alephobjects/taz-toolhead-opah/images/color_options/IMG_3160.JPG

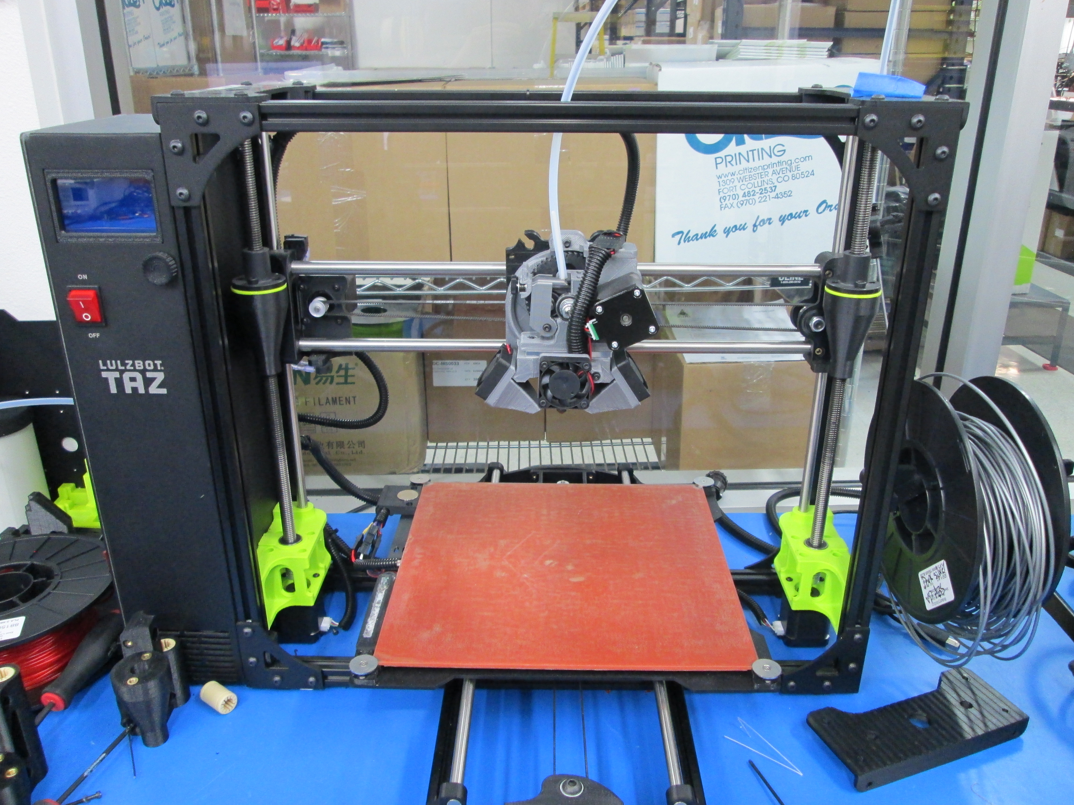
images/color_options/IMG_3160.JPG
