alephobjects/taz-toolhead-opah/images/IMG_2776.JPG

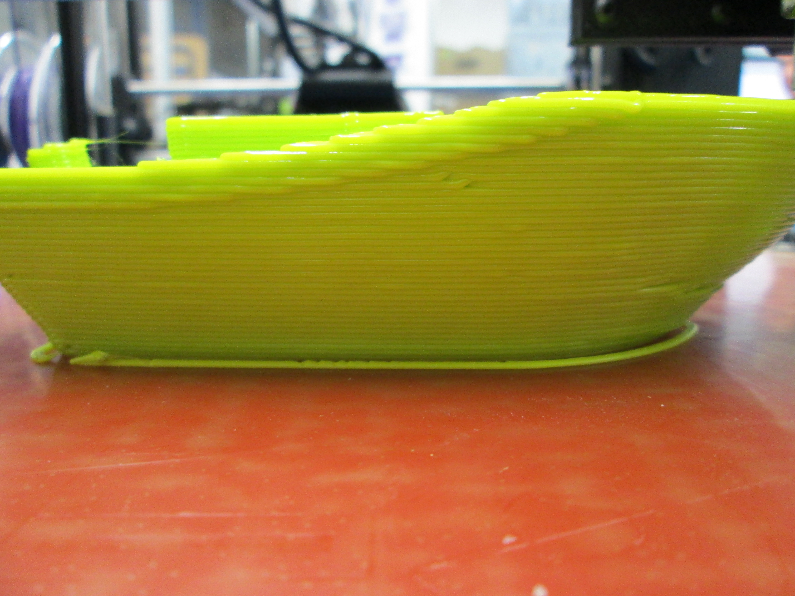
images/IMG_2776.JPG
