alephobjects/taz-toolhead-opah/production_docs/potential_retail_names.odt

Potential Opah retail names

- MOAR
- LulzBot LongBlock
- High Output Toolhead
- Hellashcnozzle
- Bignoz
- SuperSchnoz
- Cauldera
- Uberstruder
