alephobjects/taz-toolhead-opah/production_docs/notes/opah_to-do.odt

Opah todo

- Modify extruder body (rotate m4 mounting nut) (BAM)
  - print new version (Brent I)
  - validate new version (Mickey)
- Fix leaking at top of heater block (BAM)(Julie)(Mickey) Going to use resbond blue as with the standard AO-Hex
  - Resbond Blue
    - Known, but known issue (low risk)
  - Permatex Red high temp RTV
    - Unknown, but likely better (higher risk)
    - Rated to ~350C, so not future proof
- Decide on nozzle material – We're goin with Copper Alloy 328
  - Chrome Zirc 328
    - Low risk, but have over-torqued to failure
    - Similar to current nozzle with known printing and wiping abilities
  - Hardened steel
    - Higher risk, but would allow greater lifetime with abrasives
    - Wiping and printing abilities only tested for ~20 hrs, but no issues.
- Build up photo toolhead
  - Make production looking printed parts
  - Get HB laser etched
    - Decide on location for HOT logo
    - Will we also be etching writing?
  - Need picture for cura by 7/27
- Finalize printed parts
- Finalize machined parts
- Finalize vitamins
- Finalize packaging (preferred Packaging?)
  - Drop test
  - Artwork
  - Update BOM
- Finalize release print profiles
  - ABS
    - TAZ4/5 (HS, MQ, HQ)
    - TAZ6 (HS, MQ, HQ)
  - Polylite
    - TAZ4/5 (HS, MQ, HQ)
    - TAZ6 (HS, MQ, HQ)
  - nGen
    - TAZ4/5 (HS, MQ, HQ)
    - TAZ6 (HS, MQ, HQ)
  - INNOVA1800
    - TAZ4/5 (HS, MQ, HQ)
    - TAZ6 (HS, MQ, HQ)
  - T-Glase
    - TAZ4/5 (High clarity, HS, MQ, HQ)
    - TAZ6 (High clarity, HS, MQ, HQ)
  - PC-MAX
    - TAZ4/5 (HS, MQ, HQ)
    - TAZ6 (HS, MQ, HQ)
- Validate build OHAI
- Validate install OHAI
