alephobjects/taz-toolhead-opah/production_docs/notes/opah_hotend_notes.odt

Opah timeline

Beta testing begins 7/16

Bom and profile lock 8/01

Proproduction (~10 units) ??

Initial production run 9/01

Questions:

What is lead-time for 500 units?

Current action items

AO

* Need to decide on laser etching for the block and what type of nozzle identifier to use

* Mount plate was missed in initial sample run (oops)

- Getting these for preproduction run should be fine

* Heater block was redesigned to reduce cost, rounded edges are now just chamfered to match E3D block.

E3D

* Need to provide retention plate samples

* Also need to get thermistor assemblies with correct molex connector
