alephobjects/taz-toolhead-opah/images/bowling_pins_9hrs_ABS.JPG

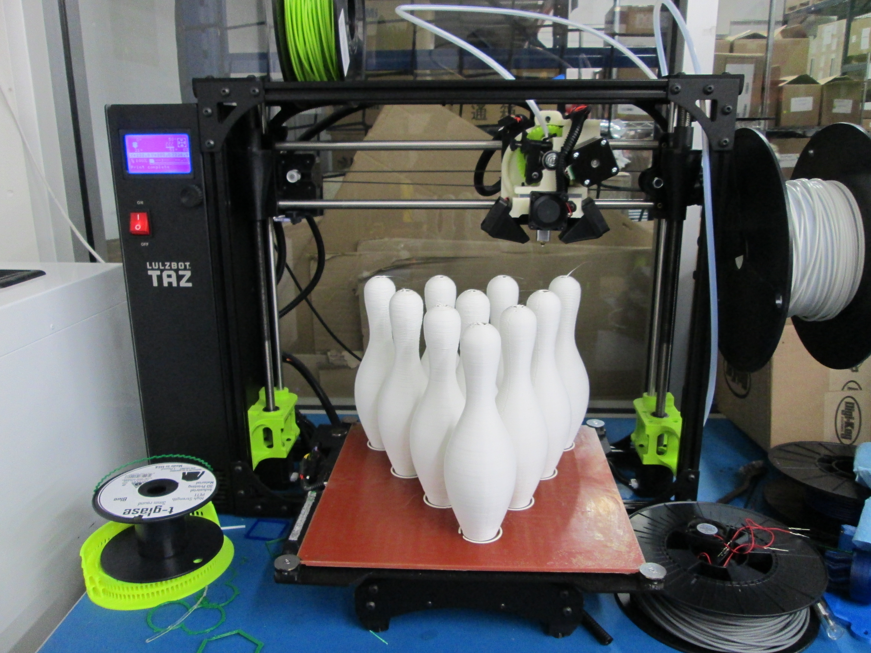
images/bowling_pins_9hrs_ABS.JPG
