alephobjects/taz-toolhead-opah/images/color_options/IMG_3157.JPG

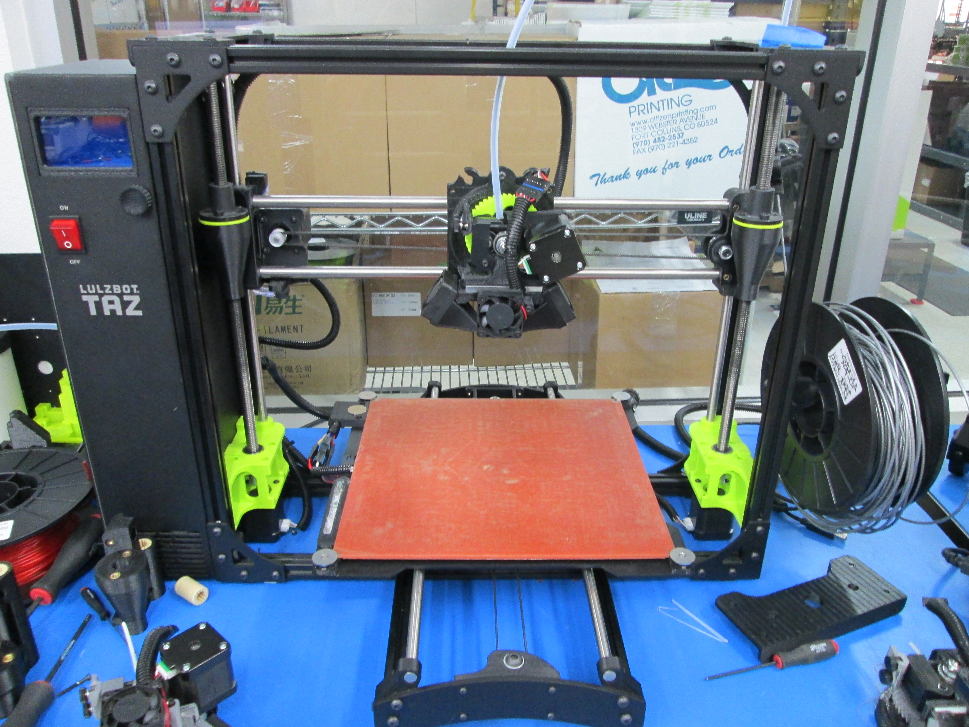
images/color_options/IMG_3157.JPG
