alephobjects/taz-toolhead-opah/images/color_options/IMG_3159.JPG

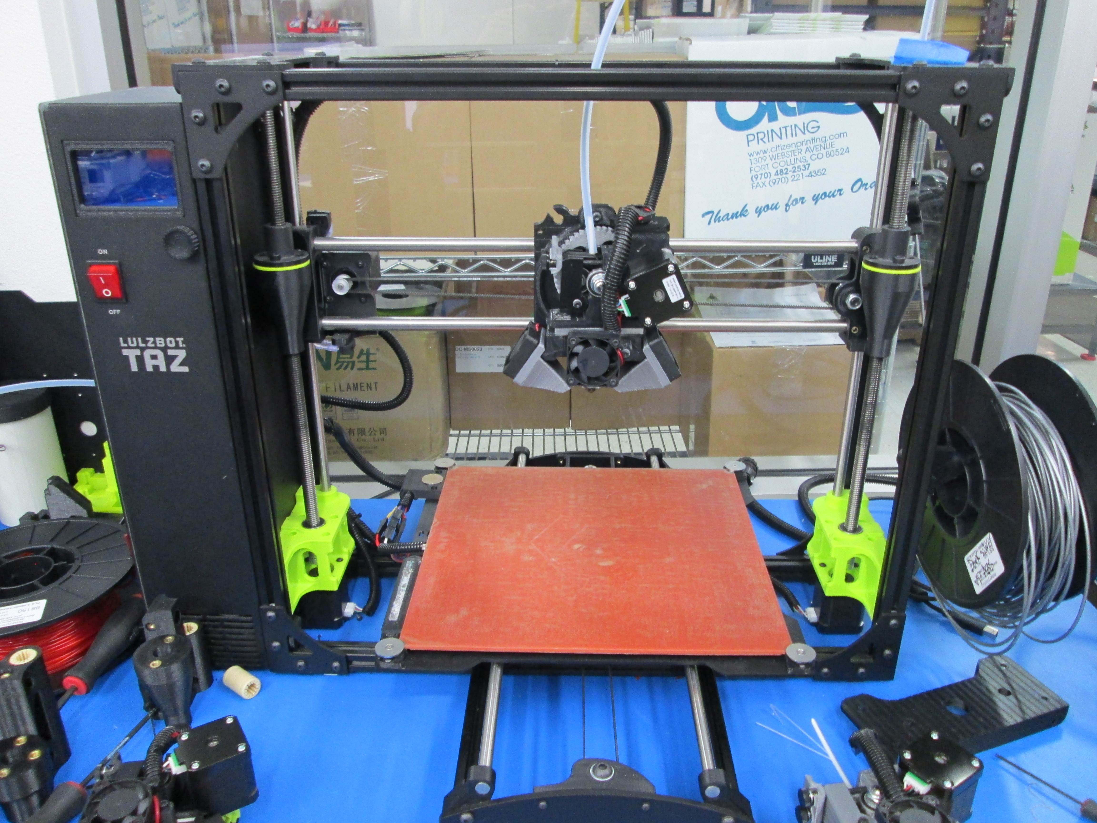
images/color_options/IMG_3159.JPG
