alephobjects/taz-toolhead-opah/images/IMG_2773.JPG

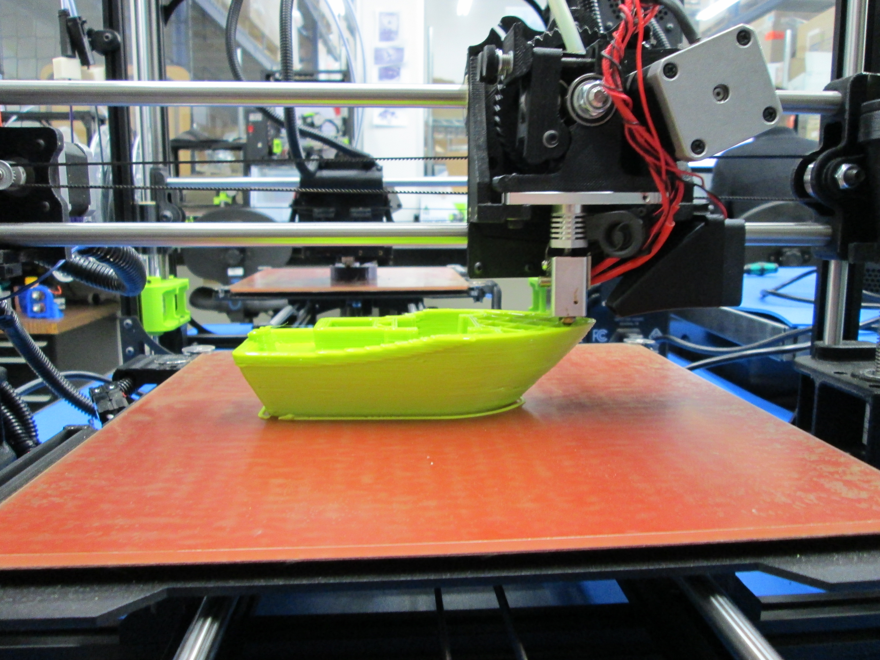
images/IMG_2773.JPG
