alephobjects/taz-toolhead-opah/images/IMG_2774.JPG

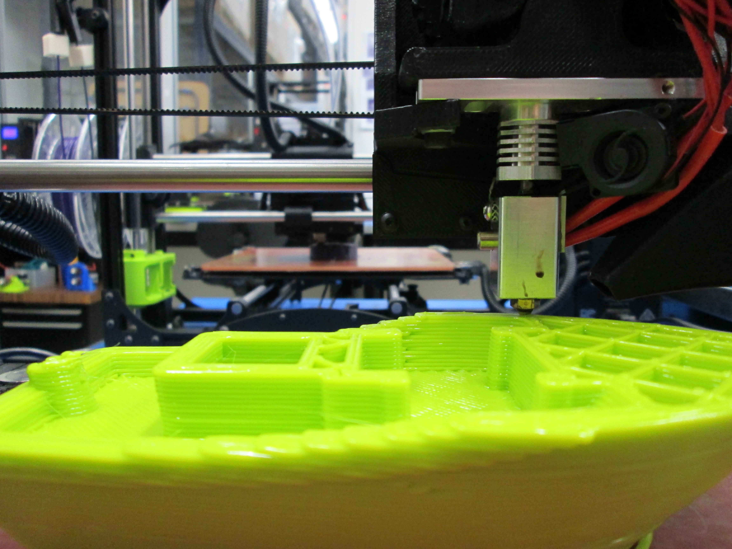
images/IMG_2774.JPG
