alephobjects/taz-toolhead-opah/images/IMG_2777.JPG

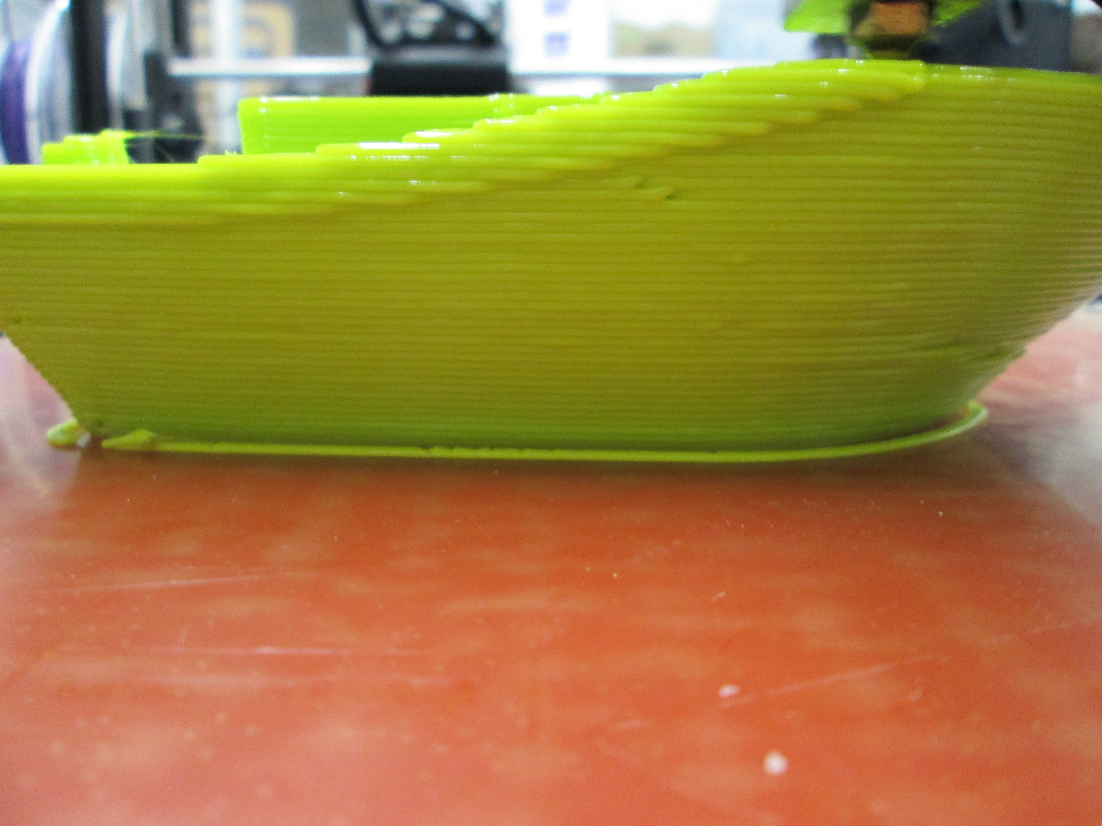
images/IMG_2777.JPG
