alephobjects/taz-toolhead-opah/images/knurled-lamp-by-ben-malouf_CS-INOVA_Opah.JPG

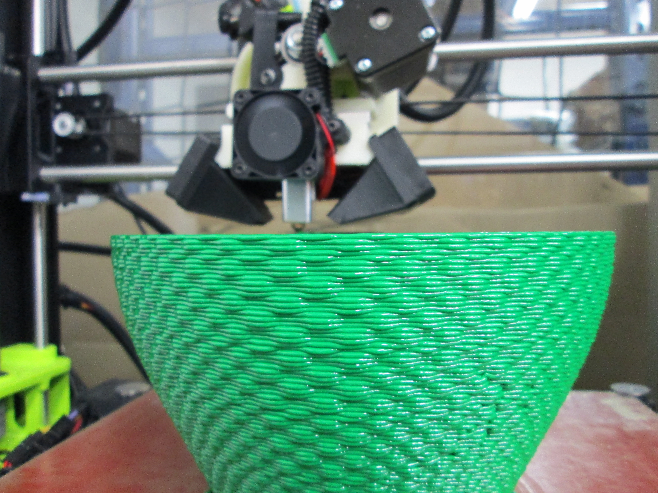
images/knurled-lamp-by-ben-malouf_CS-INOVA_Opah.JPG
