alephobjects/taz-toolhead-opah/images/lil_rocky_726g_in_6.5hrs_PLA.JPG

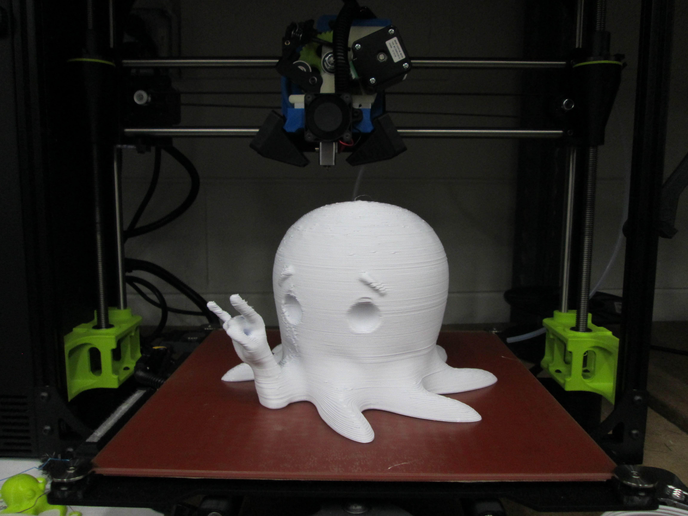
images/lil_rocky_726g_in_6.5hrs_PLA.JPG
