alephobjects/taz-toolhead-opah/images/opah_prototype_v2.jpg

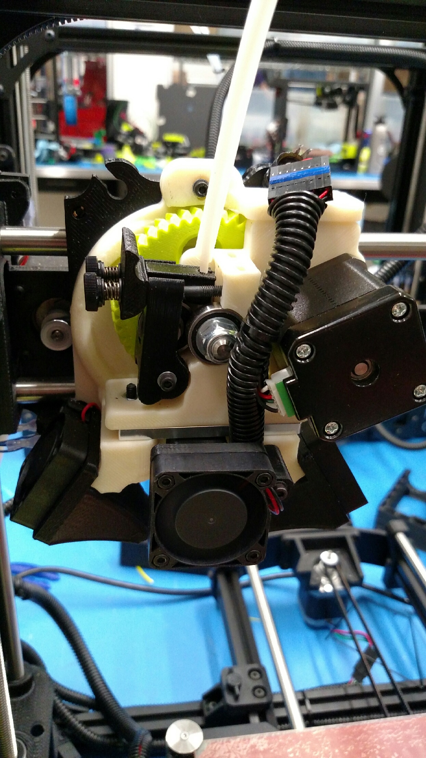
images/opah_prototype_v2.jpg
