alephobjects/taz-toolhead-opah/images/sanduchi_gunny_sack-opah-PCTPE.JPG

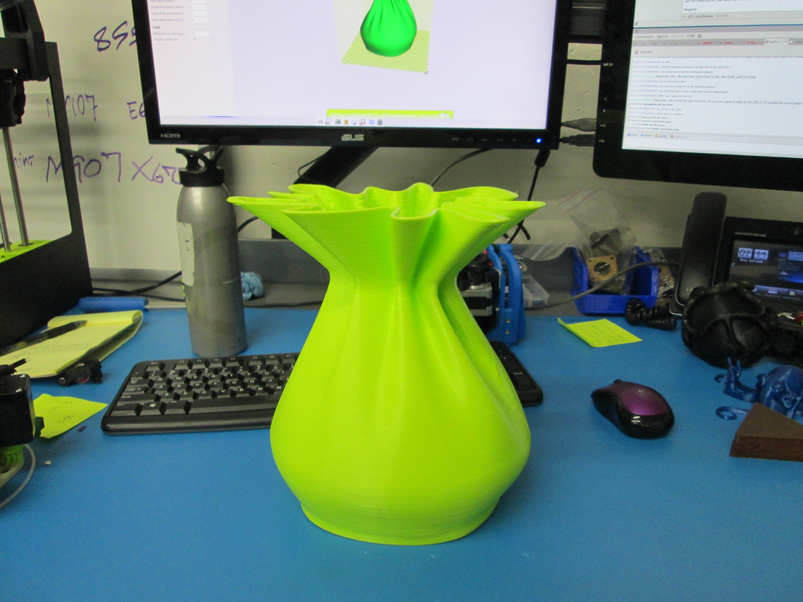
images/sanduchi_gunny_sack-opah-PCTPE.JPG
