alephobjects/taz-toolhead-opah/images/solid_polycarb_quadcopter.JPG

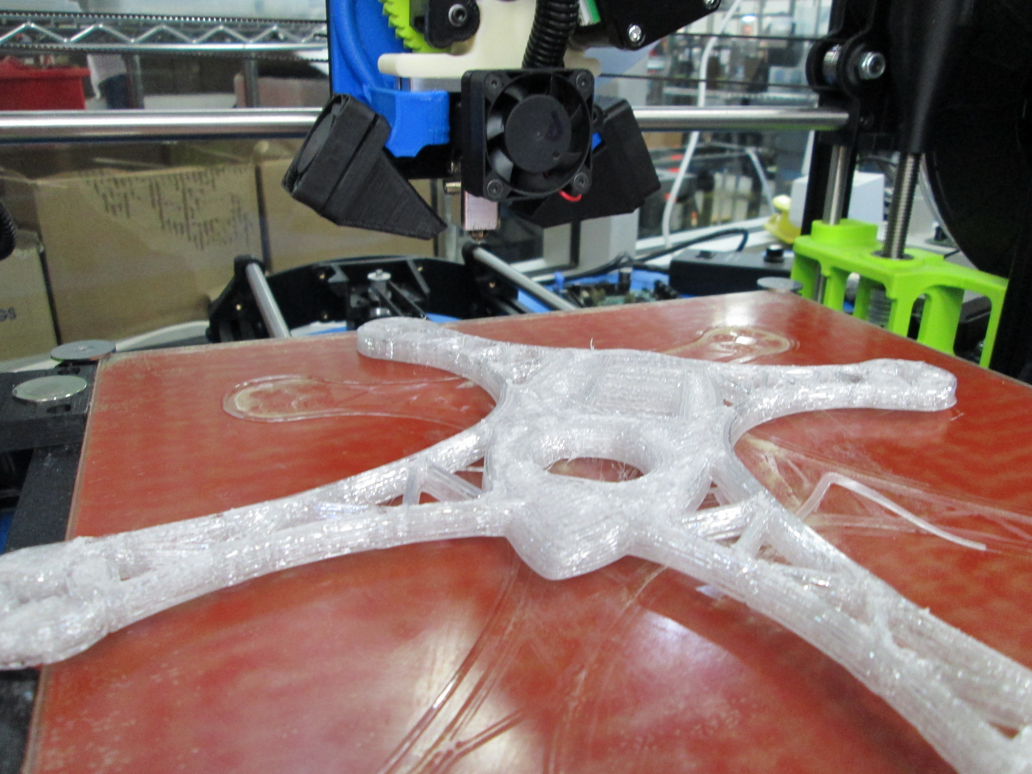
images/solid_polycarb_quadcopter.JPG
