alephobjects/taz-toolhead-opah/images/wireframe_skull_by_philnelson_opah_ABS.JPG

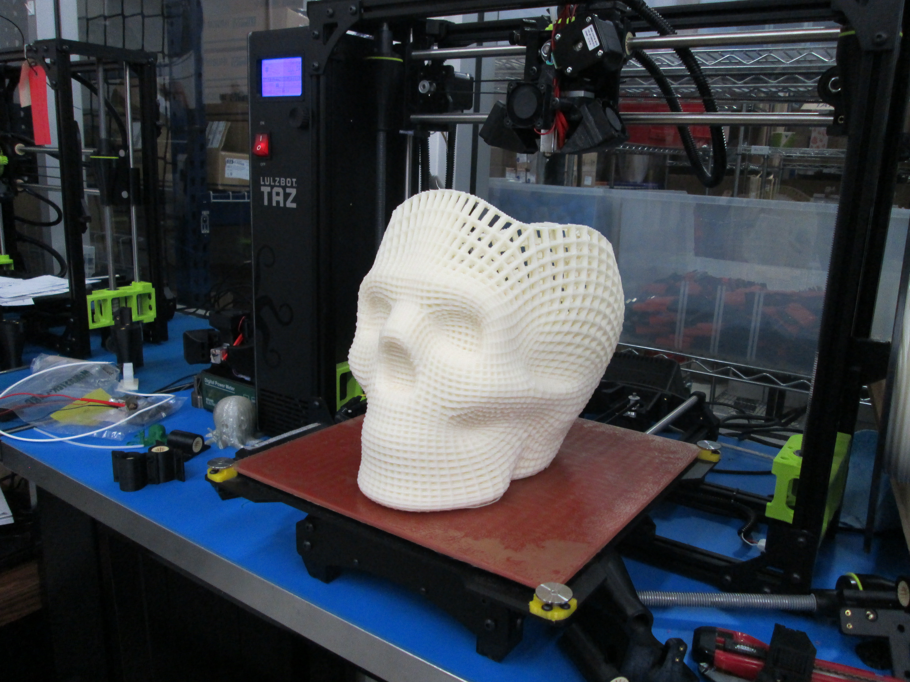
images/wireframe_skull_by_philnelson_opah_ABS.JPG
