alephobjects/taz-toolhead-opah/production_docs/opah_BOM.ods

Sheet: BOM
Opah Bill of Materials |  | Released for Purchasing 08.17.16
 |  |  |  |  |  |  |  | 500
Category | AO Part # | Description | Manufacturer | Manufacturer Part Number | Distributor | Distributor SKU | Qty Per | UOM | Price Per Unit | Price Total | Qty to order | PO | PO date | Expected date | Notes
E3D
Mechanical |  | Longblock Hexagon Hotend kit, Lulzbot Edition, 3.0mm Filament | E3D | CC-AO-300-1200-24V-40W | E3D |  | 1 | ea |  |  | 500
Electronic | EL-MS0184 | 24V 40W heater cartridge | E3D Online Ltd | E-HEATER-24V-40W | E3D Online Ltd | N/A | 1 | ea | $3.26 | $3.26 |  | PO15163 | 08/22/16 | 09/20/16 | ** converted pound to USD from quote.
Electronic | EL-TH0012 | Cartridge style thermistor with molex connector | E3D Online Ltd | CC-AO-E-SEMITEC-50-MOLEX | E3D Online Ltd | N/A | 1 | ea | $4.57 | $4.57 |  | PO15163 | 08/22/16 | 09/20/16
Mechanical | PP-MP0151 | Opah heatsink v1.0 | E3D Online Ltd | CC-AO-SINK | E3D Online Ltd | N/A | 1 | ea | $5.22 | $5.22 |  | PO15163 | 08/22/16 | 09/20/16
Mechanical | PP-MP0152 | Opah heat break v1.0 | E3D Online Ltd | CC-AO-BREAK | E3D Online Ltd | N/A | 1 | ea | $10.45 | $10.45 |  | PO15163 | 08/22/16 | 09/20/16
Mechanical | PP-MP0153 | Opah retention plate v1.0 | E3D Online Ltd | CC-AO-RETENTION | E3D Online Ltd | N/A | 1 | ea | $1.96 | $1.96 |  | PO15163 | 08/22/16 | 09/20/16
Mechanical | PP-MP0154 | Opah heater block v1.0 | E3D Online Ltd | CC-AO-BLOCK | E3D Online Ltd | N/A | 1 | ea | $5.88 | $5.88 |  | PO15163 | 08/22/16 | 09/20/16
Mechanical | PP-MP0155 | 1.2mm Opah nozzle v1.0 | E3D Online Ltd | CC-AO-NOZZLE-1200 | E3D Online Ltd | N/A | 1 | ea | $4.57 | $4.57 |  | PO15163 | 08/22/16 | 09/20/16
Mechanical | PP-MP0156 | Opah hotend mount plate v1.0 | E3D Online Ltd | CC-AO-MOUNTING-PLATE | E3D Online Ltd | N/A | 1 | ea | $5.09 | $5.09 |  | PO15163 | 08/22/16 | 09/20/16
Hardware & Electrical
Hardware | HD-MS0031 | Thumb Screw Knob for M4 SHCS, Black | Fastenal | 11102951 | Mcmaster | 91175A062 | 2 | ea | $0.18 | $0.37 | 1000 |  |  |  | 5 K min/mult at Fastenal ordered at Mcmaster
Mechanical | HD-BT0162 | Alloy Steel Cup Point Set Screw, M3 Size, 4mm Long, 0.5mm Pitch | Fastenal | 39511 | McMaster-Carr | 91390A09 | 2 | ea | $0.12 | $0.23 | 1000 | PO15254 | 08/24/16 | 09/08/16
Mechanical | HD-MS0282 | 608-2RS ABEC3/C3 Rubber Sealed Bearing – BLACK | JSB | 608-2RS ABEC3/C3 | JSB | 608-2RS ABEC3/C3 | 3 | ea | $0.42 | $1.26 | 1500 | PO15181 | 08/19/16 | 09/16/16
Mechanical | HD-RD0004 | 8mm Smooth Rod x 18-19mm, Stainless Steel (Nubbin) | Igus | EWMR-08-19 | Igus | EWMR-08-19 | 1 | ea | $1.50 | $1.50 | 500 | PO15137 | 08/19/16 | 09/14/16
Hardware | HD-BT0007 | M3 x 20 Bolt, SHCS Black-oxide | Fastenal | 39507 | McMaster-Carr | 91290A123 | 1 | ea | $0.09 | $0.09 | 500 | PO15254 | 08/24/16 | 09/08/16
Hardware | HD-BT0108 | Hobbed Bolt, M8 x 50mm Hex head, 26mm offset, Stainless Steel | Quattro | HD-BT0108 | Quattro | HD-BT0108 | 1 | ea | $4.99 | $4.99 | 500 | PO15209 | 08/23/16 | 09/06/16
Hardware | HD-NT0002 | M8 Nyloc Nut, Zinc Plated | Fastenal | 40163 | Fastenal | 40163 | 1 | ea | $0.03 | $0.03 | 500 | PO15254 | 08/24/16 | 09/08/16
Hardware | HD-WA0006 | M8 Washer, Steel, Zinc Plated | Fastenal | 1140357 | Fastenal | 1140357 | 2 | ea | $0.01 | $0.02 | 1000 | PO15254 | 08/24/16 | 09/08/16
Hardware | HD-WA0009 | Metric Spring Steel Shim - DIN 988 1.0mm Thick, 8mm ID, 14mm OD | Fastenal | 11511046 | Fastenal | 11511046 | 1 | ea | $0.05 | $0.05 | 500 | PO15254 | 08/24/16 | 09/08/16
Hardware | HD-WA0008 | Metric Spring Steel Shim - DIN 988 0.5mm Thick, 8mm ID, 14mm OD | Fastenal | 11511045 | Fastenal | 11511045 | 1 | ea | $0.05 | $0.05 | 500 | PO15254 | 08/24/16 | 09/08/16
Hardware | HD-BT0052 | M4 x 55 Bolt, SHCS Black-OxideMetric Class 12.9 Socket Head Cap Screw M4 Thread, 55mm Length, 0.70mm Pitch | Fastenal | ZT2530055PF000 | Fastenal | ZT2530055PF0000 | 2 | ea | $0.08 | $0.16 | 1000 | PO15254 | 08/24/16 | 09/08/16
Hardware | HD-BT0010 | M4 x 20 Bolt SHCS Black-Oxide | Fastenal | 1139527 | Fastenal | 1139527 | 2 | ea | $0.01 | $0.03 | 1000 | PO15254 | 08/24/16 | 09/08/16
Hardware | HD-WA0039 | Black-Oxide 18-8 Stainless Steel Flat Washer, M4 Screw Size, 4.3mm ID, 9.0mm OD | Fastenal | 11264487 | Fastenal | 11264487 | 6 | ea | $0.03 | $0.19 | 3000 | PO15254 | 08/24/16 | 09/08/16
Hardware | HD-NT0011 | M4 Nut, Steel, Zinc Plated | Fastenal | 40303 | Fastenal | 40303 | 4 | ea | $0.00 | $0.02 | 2000 | PO15254 | 08/24/16 | 09/08/16
Hardware | HD-MS0027 | Extruder Comp Spring - Music Wire, Extruder, 6mm OD, 0.8mm WD, 9.7mm FL | Associated Spring | C0240-032-0380-M | Associated Spring | C0240-032-0380-M | 2 | ea | $0.06 | $0.12 | 1000 | PO15182 | 08/22/16 | 09/19/16
Hardware | HD-BT0041 | Metric Class 12.9 Socket Head Cap Screw Alloy Steel, M3 Thread, 25mm Length, 0.50mm Pitch | Fastenal | 39508 | Fastenal | 39508 | 2 | ea | $0.03 | $0.06 | 1000 | PO15254 | 08/24/16 | 09/08/16
Hardware | HD-BT0104 | M3 x 8 Bolt, BHCS, SST | Fastenal | MB2510008A20000 | Fastenal | MB2510008A20000 | 2 | ea | 0.0882 | $0.18 | 1000 | PO15254 | 08/24/16 | 09/08/16
Hardware | HD-BT0039 | Metric Class 12.9 Socket Head Cap Screw, Alloy Steel, M3 Thread, 12MM Length, 0.50MM Pitch | Fastenal | 39505 | Fastenal | 39505 | 11 | ea | $0.03 | $0.32 | 5500 | PO15254 | 08/24/16 | 09/08/16
Hardware | HD-BT0012 | M3 Set Screw (Grub Screw) | Fastenal | 40818 | Fastenal | 40818 | 1 | ea | $0.02 | $0.02 | 500 | PO15254 | 08/24/16 | 09/08/16
Hardware | HD-BT0146 | M3 x 12 BHCS, Black Oxide, Class 10.9 Steel | Fastenal | 40870 | Fastenal | 40870 | 2 | ea | $0.19 | $0.38 | 1000 | PO15254 | 08/24/16 | 09/08/16
Hardware | HD-WA0038 | Black-Oxide 18-8 Stainless Steel Flat Washer, M3 Screw Size, 3.2mm ID, 7.0mm OD | Fastenal | 11264395 | McMaster-Carr | 98269A420 | 8 | ea | $0.02 | $0.20 | 4000 | PO15254 | 08/24/16 | 09/08/16
Hardware | HD-BT0118 | M3 x 14 Bolt FHCS, Black-Oxide | Fastenal | 40925 | Mcmaster | 91280A550 | 4 | ea | $0.02 | $0.08 | 2000 | PO15254 | 08/24/16 | 09/08/16
Hardware | HD-NT0004 | M3 Nut, Steel, Zinc Plated | Fastenal | 40302 | Fastenal | 40302 | 2 | ea | $0.01 | $0.01 | 1000 | PO15254 | 08/24/16 | 09/08/16
Hardware | HD-MS0030 | Metric Brass Heat-Set Insert for Plastics Tapered, M3-.5 Internal Thread, 3.8mm Length | CEH – Colorado Electrical Hardware | IUBB-M3-1 | CEH – Colorado Electrical Hardware | IUBB-M3-1 | 15 | ea | $0.05 | $0.75 | 7500 | PO15136 | 08/19/16 | 09/15/16
Hardware | HD-WA0027 | Metric 18-8 Stainless Steel Internal-Tooth Lock Washer, M3 Screw Size, 6mm OD, .4mm min Thick | Fastenal | WF6330000A20000 | McMaster-Carr | 93925A240 | 1 | ea | $0.01 | $0.01 | 500 | PO15254 | 08/24/16 | 09/08/16
Hardware | HD-MS0058 | Wire Tie, 8" Black | EDC – Electronics Distributors Corporation | APU-08-18-0-M | EDC – Electronics Distributors Corporation | APU-08-18-0-M | 2 | ea | $0.01 | $0.02 | 1000 | see note |  | see note | 205,000 inventory
Electronic | EL-MT0029 | NEMA 17 Stepper Motor, Moons' - NOT INCLUDING wire harness - As per attached Drawing. | Moons | MS17HD6P4150MS17HD6P4150-01-B | Moons | MS17HD6P4150-01-B | 1 | ea | $8.30 | $8.30 | 500 | see note |  | see note | Pull from current inventory, per Toni.
Electronic | EL-FA0032 | Pelonis FAN 24V 40x40mm Low flow | Pelonis | C4010L24BPLB1-7 | Pelonis | C4010L24BPLB1-7 | 2 | ea | $3.13 | $6.26 | 1000 | PO15132 | 08/19/16 | 09/15/16 | m/m 200 pc
Electronic | EL-FA0034 | Pelonis FAN 5V 40x10mm Low flow | Pelonis | C4010L05BPLB1b-7 | Pelonis | C4010L05BPLB1b-7 | 1 | ea | $3.07 | $3.07 | 500 | PO15132 | 08/19/16 | 09/15/16 | m/m 200 pc
Electronic | EL-MS0059 | Molex-CONN TERM FEMALE 22-24AWG TIN Reels of 20K | Molex | 16-02-0086 | TTI | 16-02-0086 | 2 | ea | $0.01 | $0.03 | 1000 | PO15149 | 08/23/16 | 09/02/16 | PO for extruders, Javelin and Longfin will cover this 1000 pcs comes in 20,000 pc reels.
Electronic | PC-CN0001 | Molex-Conn Housing 2POS .100 W/Latch | Molex | 50579402 | Sager | 50579402 | 1 | ea | $0.05 | $0.05 | 500 | PO15208 | 08/23/16 | 09/06/16
Electronic | EL-MS0141 | Term Ring Non Ins 26-22AWG #4 Order Bulk Only | Panduit | P22-4R-M | TTI | P22-4R-M | 1 | ea | $0.06 | $0.06 | 500 | PO15202 | 08/23/16 | 09/08/16
Electronic | EL-MS0416 | Solder Sleeve B155-9002, one step | TE Connectivity | B-155-9002 | TTI | A104858-ND | 2 | ea | $0.29 | $0.58 | 1000 | PO15202 | 08/23/16 | 09/08/16
Electronic | EL-MS0205 | Molex-CONN TERM MALE 22-24AWG TIN - Reels of 20K | Molex | 16-02-0107 | TTI | 16-02-0107 | 13 | ea | $0.02 | $0.24 | 6500 | PO15149 | 08/23/16 | 09/02/16 | PO for extruders, Javelin and Longfin will cover this 1000 pcs comes in 20,000 pc reels.
Electronic | EL-MS0251 | CONN HOUSING 16POS .100 DUAL | Molex | 22552161 | TTI | 22552161 | 1 | ea | $0.53 | $0.53 | 500 | PO15202 | 08/23/16 | 09/08/16
Electronic | EL-MS0351 | JST – CONN TERM CRIMP PH 24-30AWG | JST Sales America, Inc. | SPH-002T-P0.5S | Digi-Key /Future Electronics | 455-1127-1-ND | 4 | pcs | $0.01 | $0.05 | 2000 | PO15139 | 08/22/16 | 09/14/16
Electronic | EL-MS0355 | CONN HOUSING PH 6POS 2MM WHITE | JST Sales America, Inc. | PHR-6 | Digikey/ Future |  | 1 | ea | $0.03 | $0.03 | 500 | PO15139 | 08/22/16 | 09/14/16
Electronic | EL-WR0103 | 24AWG Stranded – Red | Allcable | HU1569247RD | Allcable | HU1569247RD | 110 | mm | $0.00 | $0.01 | 55000 | PO15203 | 08/23/16 | 09/06/16 | 181'
Electronic | EL-WR0105 | 24AWG Stranded – Black | Allcable | HU1569247BK | Allcable | HU1569247BK | 110 | mm | $0.00 | $0.01 | 55000 | PO15203 | 08/23/16 | 09/06/16 | 181'
Electronic | EL-WR0120 | 24AWG Stranded – Purple | Allcable | HU1569247VT | Allcable | HU1569247VT | 150 | mm | $0.00 | $0.01 | 75000 | PO15203 | 08/23/16 | 09/06/16 | 247'
Electronic | EL-WR0109 | 24AWG Stranded – Yellow | Allcable | HU1569247YW | Allcable | HU1569247YW | 150 | mm | $0.00 | $0.02 | 75000 | PO15203 | 08/23/16 | 09/06/16 | 247'
Electronic | EL-WR0040 | Wire - Single Conductor 20AWG SOLID PTFE, RED | Alpha Wire | 2856/1 | Allcable |  | 175 | mm | $0.00 | $0.64 | 87500 | PO15203 | 08/23/16 | 09/06/16 | 288'
Electronic | EL-MS0139 | Tubing Corrugated Loom 3/8" ID, Black, 1900' Box | EDC – Electronics Distributors Corporation | 88-00012 | EDC – Electronics Distributors Corporation | 88-00012 | 100 | mm |  |  | 50000 | PO15210 | 08/23/16 | 09/07/16 | 165'
Printed
Printed | PP-GP0062 | herringbone_small_gear, Black | Aleph Objects, inc. | PP-GP0062 | Aleph Objects, inc. | PP-GP0062 | 1 | ea | $0.34 | $0.34 | 500
Printed | PP-GP0061 | herringbone_large_gear, Black | Aleph Objects, inc. | PP-GP0061 | Aleph Objects, inc. | PP-GP0061 | 1 | ea | $2.43 | $2.43 | 500
Printed | PP-GP0060 | Wade Reloaded Bearing Washer, Black | Aleph Objects, inc. | PP-GP0060 | Aleph Objects, inc. | PP-GP0060 | 1 | ea | $0.02 | $0.02 | 500
Printed | PP-GP0212 | Fan duct right v0.1, TAZ, Black | Aleph Objects, inc. | PP-GP0212 | Aleph Objects, inc. | PP-GP0212 | 1 | ea | $1.70 | $1.70 | 500
Printed | PP-GP0211 | Fan duct left v0.1, TAZ, Black | Aleph Objects, inc. | PP-GP0211 | Aleph Objects, inc. | PP-GP0211 | 1 | ea | $1.70 | $1.70 | 500
Printed | PP-GP0241 | Beefy extruder idler v0.3, Black | Aleph Objects, inc. | PP-GP0241 | Aleph Objects, inc. | PP-GP0241 | 1 | ea | $0.90 | $0.90 | 500
Printed | PP-GP0242 | Heatsink fan duct opah v1.1, Dark Silver | Aleph Objects, inc. | PP-GP0242 | Aleph Objects, inc. | PP-GP0242 | 1 | ea | $1.25 | $1.25 | 500 |  |  |  | PO15494 pulling in Dark Silver ABS for this part
Printed | PP-GP0243 | Opah extruder body v0.2, Dark Silver | Aleph Objects, inc. | PP-GP0243 | Aleph Objects, inc. | PP-GP0243 | 1 | ea | $4.01 | $4.01 | 500 |  |  |  | PO15494 pulling in Dark Silver ABS for this part
Printed | PP-GP0244 | Opah extruder brace v0.3, Dark Silver | Aleph Objects, inc. | PP-GP0244 | Aleph Objects, inc. | PP-GP0244 | 1 | ea | $1.00 | $1.00 | 500 |  |  |  | PO15494 pulling in Dark Silver ABS for this part
Printed | PP-GP0245 | Opah idler latch v2.2, Dark Silver | Aleph Objects, inc. | PP-GP0245 | Aleph Objects, inc. | PP-GP0245 | 1 | ea | $0.26 | $0.26 | 500 |  |  |  | PO15494 pulling in Dark Silver ABS for this part
Printed | PP-GP0246 | Opah extruder mount v1.2, Dark Silver | Aleph Objects, inc. | PP-GP0246 | Aleph Objects, inc. | PP-GP0246 | 1 | ea | $6.51 | $6.51 | 500 |  |  |  | PO15494 pulling in Dark Silver ABS for this part
Packaging
Consumable | RM-MS0035 | nGen Amphora (colorFabb) Sample Pack, AM3300 Polymer, LulzBot Green | colorFabb B.V. |  | colorFabb B.V. |  | 1 | ea | $0.00 |  | 500
Shipping | HD-MS0348 | ESD Foam 40mm x 20mm x 10mm - Extruder Pin Protector | Paqsource |  | Paqsource | 015-29146 | 1 | ea | $0.03 | $0.03 | 500 |  |  |  | Toni is working with Preferred on this item.
Shipping | SH-PG0059 | Mailers, Indestructo, 7 x 5 x 4 |  |  | Uline | S-971 | ? | ea | $0.76 | #VALUE! | #VALUE!
Shipping | SH-PA0019 | Bubble 1/8x48x750 perf 12" slit 2-24" rolls |  |  | Shipper Supply |  | ? | sheet | $0.15 | #VALUE! | #VALUE!
Shipping | SH-PA0039 | Roll of 48"x1/4" Thick Foam, Split at 12" - 225 feet Per Roll |  |  | Shipper Supply |  | ? | ea |  | #VALUE! | #VALUE!
Label | DC-LB0109 | Label, LulzBot TAZ Opah Tool Head v2c, 1.2 Nozzle, Front |  |  | Sticker Giant |  | ? | ea | $0.23 | #VALUE! | #VALUE!
Label | DC-LB0110 | Label, LulzBot TAZ Opah Tool Head v2c, 1.2 Nozzle, Back |  |  | Sticker Giant |  | ? | ea | $0.23 | #VALUE! | #VALUE!
Documentation | DC-MS0047 | v2 Tool Head Instruction Card |  |  |  |  | ? | ea | $0.080 | #VALUE! | #VALUE! |  |  |  | check with Ben and Steven for any updates, before ordering.

Sheet: printed part status
Category | Part No | Name | Qty | UOM | Status
Printed |  | Extruder body for Hex nozzle v2.0 | 1 | ea | Use braced version
Printed |  | Extruder body brace | 1 | ea | Need to add cutout for the wire harness
Printed |  | opah_extruder_latch | 1 | ea | Testing slim version
Printed | PP-GP0062 | herringbone_small_gear | 1 | ea | Use same as TAZ 6 - material???
Printed | PP-GP0061 | herringbone_large_gear | 1 | ea | Use same as TAZ 6 - material???
Printed | PP-GP0060 | Wade Reloaded Bearing Washer | 1 | ea | use same as TAZ 6
Printed |  | Wade Reloaded Idler Block v1.4b, Taz & Mini | 1 | ea | Testing thickened version
Printed |  | Heatsink Fan Duct, Opah, v1.0 | 1 | ea | Need to redraw, have blender part currently
Printed | PP-GP0212 | Fan duct right v0.1, TAZ | 1 | ea | use same as TAZ 6
Printed | PP-GP0211 | Fan duct left v0.1, TAZ | 1 | ea | use same as TAZ 6
Printed |  | Opah_extruder_mount | 1 | ea | Fix non-manifold
