alephobjects/taz-toolhead-opah/production_parts/printed_parts/printed_part_status_opah.ods

Part number | Part name | Color ABS | Model status | Number requested | Status | Notes | G code version | Mechanical Approval
 | opah_extruder_body_v0.2 | Dark Silver ABS | Ready to print | 4 | BI cosmetic apprv |  | 0.0.0.0 | Y
 | opah_extruder_brace_v0.3 | Dark Silver ABS | Ready to print | 4 | BI cosmetic apprv |  | 0.0.0.0 | Y
 | beefy_extruder_idler_v0.3 | Black ABS | Ready to print | 4 | part change |  | 0.0.0.0 | Y
 | opah_extruder_mount_v1.2 | Dark Silver ABS | Ready to print | 4 |  |  | 0.0.0.0 | Y
 | jonaskuehling_gregs-wade-ao-v3-washer | Black ABS | Ready to print | 4 | BI cosmetic apprv | These can likely be pulled from production parts
 | fan_duct_left_v0.7.4.1d | Black ABS | Ready to print | 4 | BI cosmetic apprv | These can likely be pulled from production parts | 0.0.0.0 | Y
 | fan_duct_right_v0.7.4.1d | Black ABS | Ready to print | 4 |  | These can likely be pulled from production parts | 0.0.0.0 | Y
 | heatsink_fan_duct_opah_v1.1 | Dark Silver ABS | Ready to print | 4 | BI cosmetic apprv |  | 0.0.0.0 | Y
 | beefy_idler_latch_v2.2 | Dark Silver ABS | Ready to print | 4 |  |  | 0.0.0.0 | Y
 | herringbone_large_gear_v1.3 | Black ABS | Ready to print | 4 | BI cosmetic apprv | These can likely be pulled from production parts
 | herringbone_small_gear-1.1-highres | Black ABS | Ready to print | 4 | BI cosmetic apprv | These can likely be pulled from production parts
