alephobjects/taz-toolhead-opah/production_docs/HE-SH0046_high_output_hexagon_hotend_kit.ods

HE-SH0046 High output Hexagon Hotend kit BOM
This is what we expect to receive when we order Part No. HE-SH0046 from reprap discount
1x AO-Hex heatsink for 3mm filament
1x Opah heater block v0.9 (see drawing)
1x Semitec GT2 thermistor (100kOhm type) Thermistor needs 23cm leads with no connectors on end
2x heater cartridge 24V 30W Heater cartridge needs 23cm leads with no connectors on end
1x extended retention plate (see drawing)
1x standard hexagon mount plate
2x M3 x6 setscrew (heater cartridge set screw)
1x heat sink setscrew (M2x6 SCHS)
