alephobjects/taz-toolhead-opah/production_parts/jigs/flexy_heatsink_holder_v0.1.fcstd

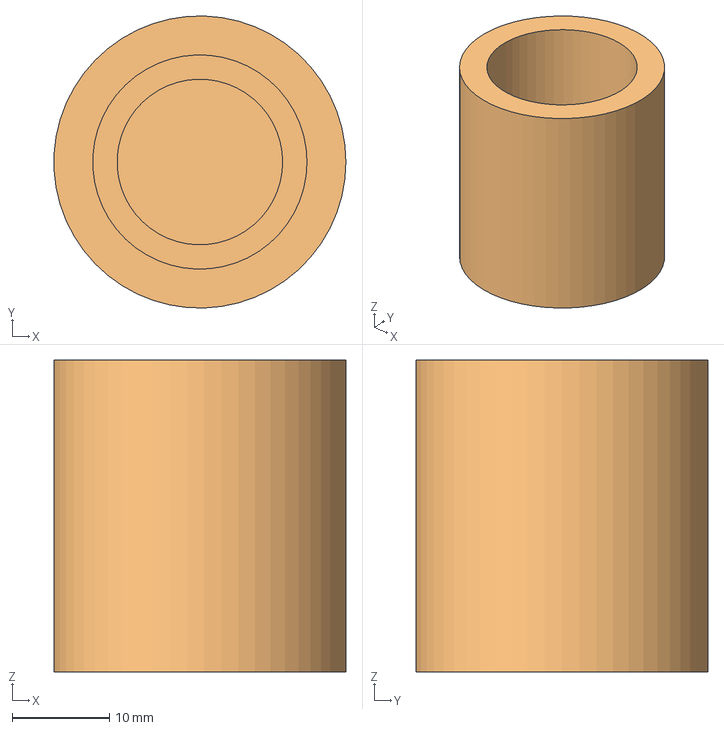
[picture p15: CAD file, 2016-07-01]
production_parts/jigs/flexy_heatsink_holder_v0.1.fcstd
30.0 x 30.0 x 32.0 mm
