alephobjects/taz-toolhead-opah/production_parts/machined_parts/1.2mm-MOARstruder-nozzle/1.2mm-MOARstruder-nozzle_PP-MP0155_revB.step

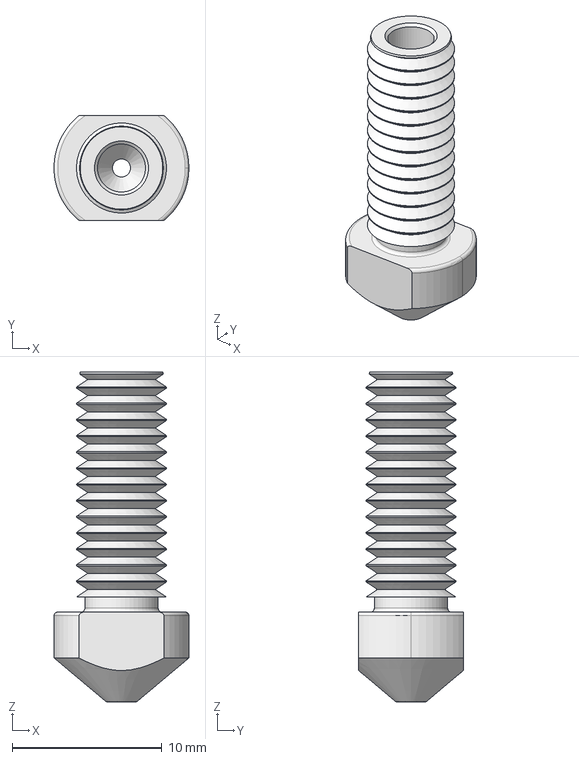
[picture p16: CAD file, 2016-10-12]
production_parts/machined_parts/1.2mm-MOARstruder-nozzle/1.2mm-MOARstruder-nozzle_PP-MP0155_revB.step
9.00 x 7.00 x 22.0 mm
