alephobjects/taz-toolhead-opah/production_parts/machined_parts/ATTIC/heater_block/opah_heater_block_v0.9.fcstd

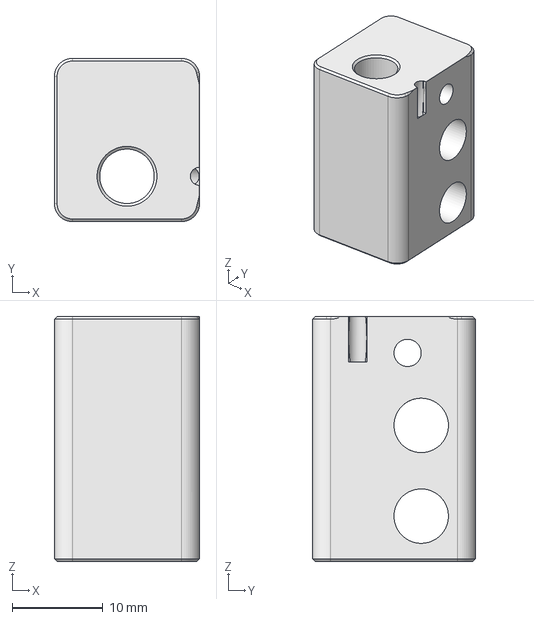
[picture p17: CAD file, 2016-05-05]
production_parts/machined_parts/ATTIC/heater_block/opah_heater_block_v0.9.fcstd
16.0 x 18.0 x 27.0 mm
