alephobjects/taz-toolhead-opah/production_parts/machined_parts/ATTIC/heatsink/Cooling_Block_3mm_short.fcstd

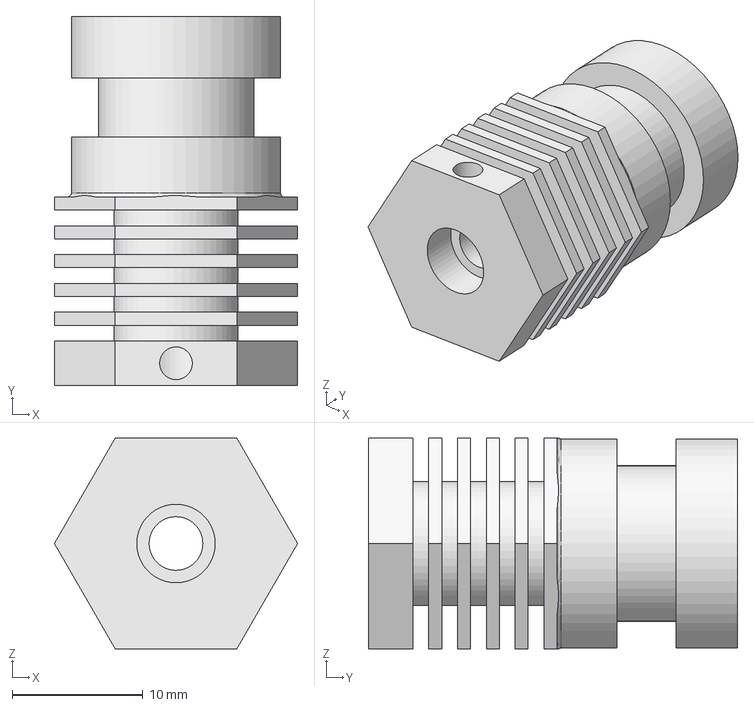
[picture p18: CAD file, 2016-05-05]
production_parts/machined_parts/ATTIC/heatsink/Cooling_Block_3mm_short.fcstd
18.6 x 28.2 x 16.1 mm
