alephobjects/taz-toolhead-opah/production_parts/machined_parts/MOARstruder-heatbreak/MOARstruder-heatbreak_PP-MP0152_revA.step

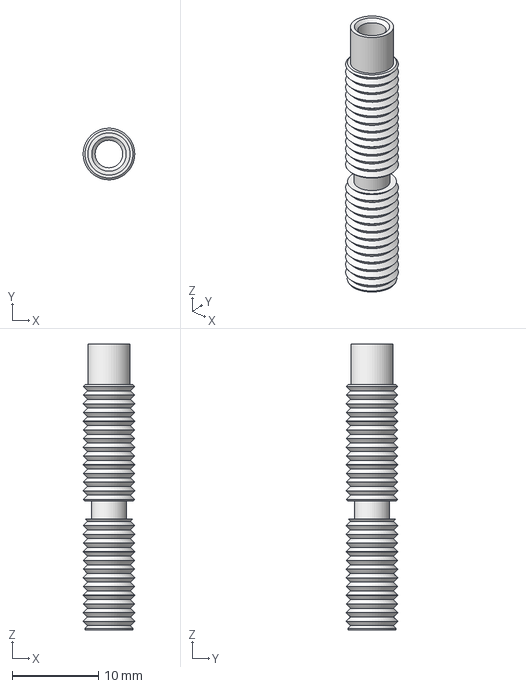
[picture p19: CAD file, 2016-10-12]
production_parts/machined_parts/MOARstruder-heatbreak/MOARstruder-heatbreak_PP-MP0152_revA.step
5.99 x 6.00 x 33.2 mm
