alephobjects/taz-toolhead-opah/production_parts/machined_parts/MOARstruder-heater-block/MOARstruder-heater-block_PP-MP0154_revB.fcstd

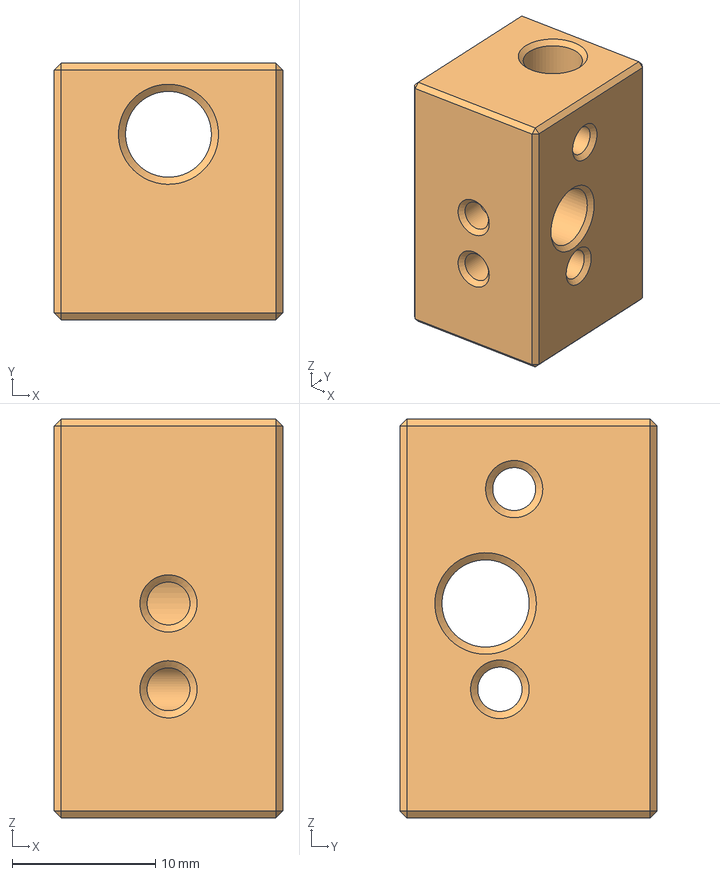
[picture p20: CAD file, 2016-10-12]
production_parts/machined_parts/MOARstruder-heater-block/MOARstruder-heater-block_PP-MP0154_revB.fcstd
16.0 x 18.0 x 27.9 mm
