alephobjects/taz-toolhead-opah/production_parts/machined_parts/MOARstruder-heatsink/MOARstruder-heatsink_PP-MP0151_revA.fcstd

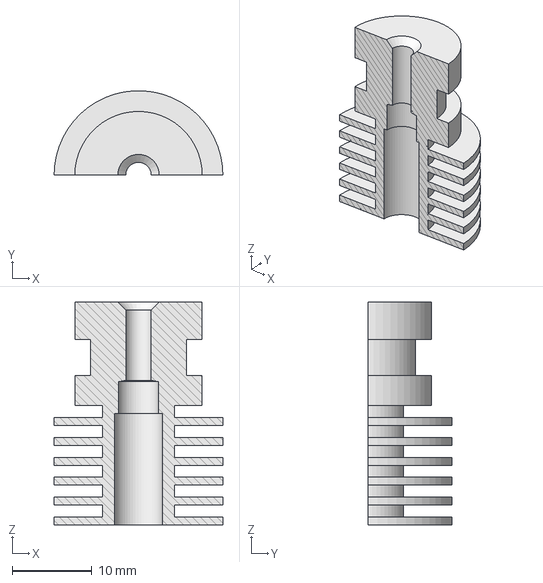
[picture p21: CAD file, 2016-10-12]
production_parts/machined_parts/MOARstruder-heatsink/MOARstruder-heatsink_PP-MP0151_revA.fcstd
21.2 x 10.6 x 28.0 mm
