alephobjects/taz-toolhead-opah/production_parts/machined_parts/MOARstruder-mount-plate/MOARstruder-mount-plate_PP-MP0156_revA.fcstd

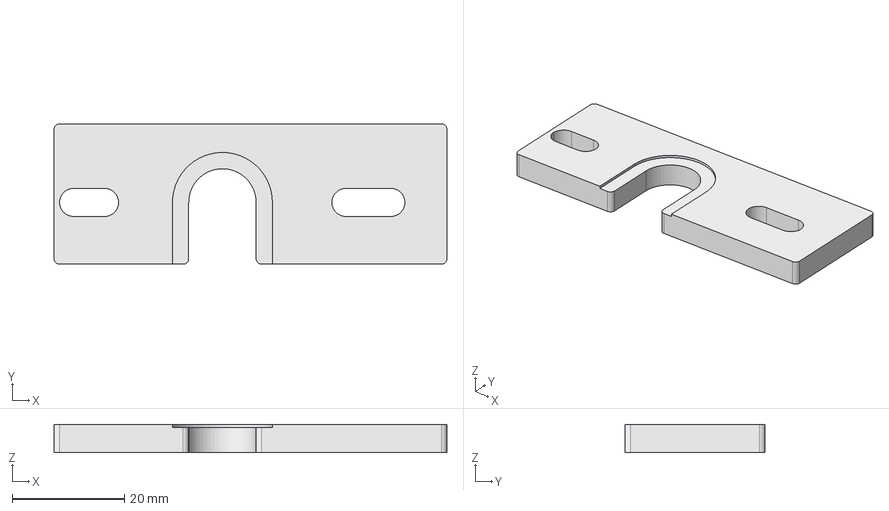
[picture p22: CAD file, 2016-10-12]
production_parts/machined_parts/MOARstruder-mount-plate/MOARstruder-mount-plate_PP-MP0156_revA.fcstd
70.0 x 25.0 x 5.00 mm
