alephobjects/taz-toolhead-opah/production_parts/machined_parts/MOARstruder-retention-plate/MOARstruder-retention-plate_PP-MP0153_revA.fcstd

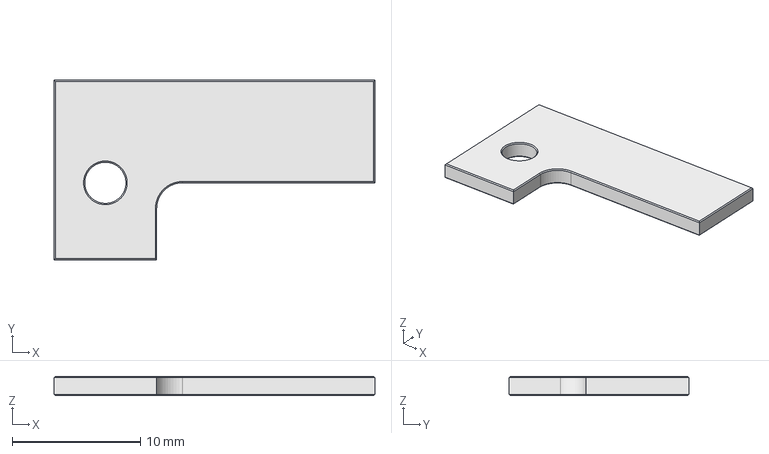
[picture p23: CAD file, 2016-10-12]
production_parts/machined_parts/MOARstruder-retention-plate/MOARstruder-retention-plate_PP-MP0153_revA.fcstd
25.0 x 14.0 x 1.50 mm
