alephobjects/taz-toolhead-opah/production_parts/printed_parts/extruder_body/opah_extruder_body_v0.2.stl

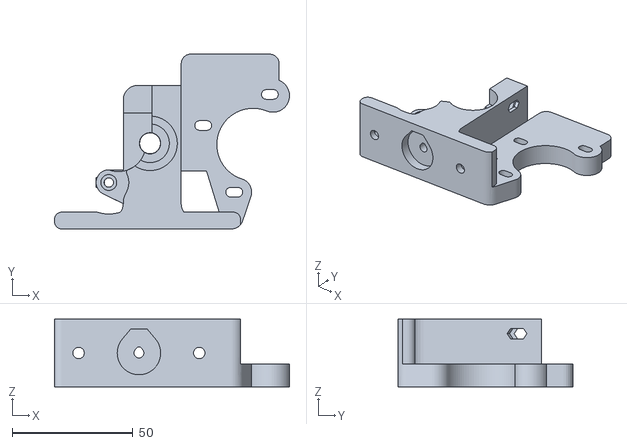
[picture p24: CAD file, 2016-07-21]
production_parts/printed_parts/extruder_body/opah_extruder_body_v0.2.stl
97.4 x 72.5 x 28.0
