alephobjects/taz-toolhead-opah/production_parts/printed_parts/extruder_brace/opah_extruder_brace_v0.4.fcstd

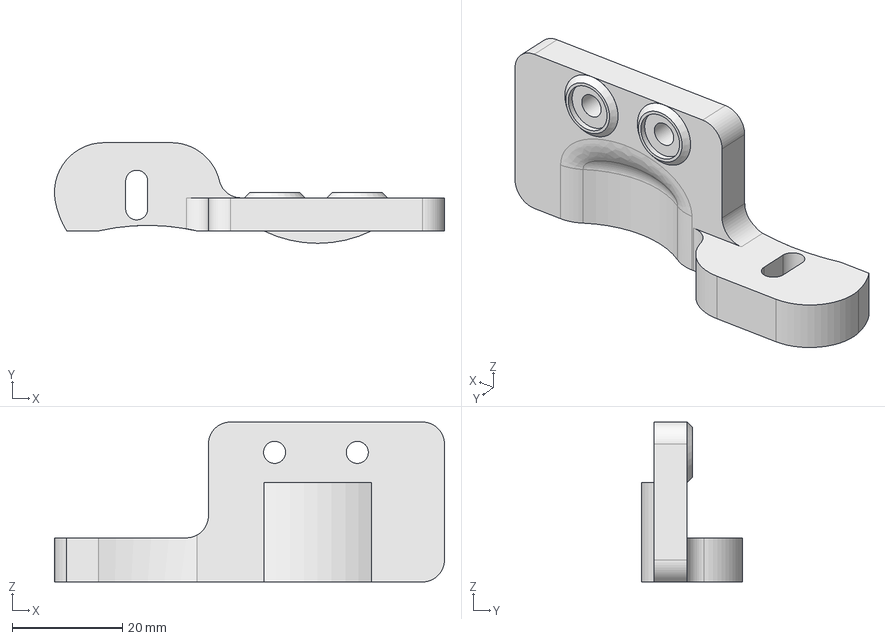
[picture p25: CAD file, 2016-09-27]
production_parts/printed_parts/extruder_brace/opah_extruder_brace_v0.4.fcstd
70.7 x 18.3 x 29.0 mm
