alephobjects/taz-toolhead-opah/production_parts/printed_parts/extruder_idler/beefy_extruder_idler_v0.4.fcstd

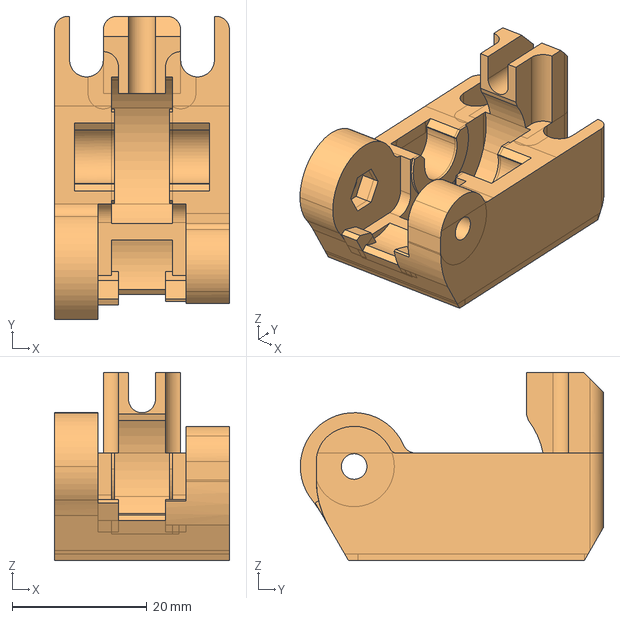
[picture p26: CAD file, 2016-10-11]
production_parts/printed_parts/extruder_idler/beefy_extruder_idler_v0.4.fcstd
26.0 x 45.1 x 28.0 mm
