alephobjects/taz-toolhead-opah/production_parts/printed_parts/extruder_mount/opah_extruder_mount_v1.2.stl

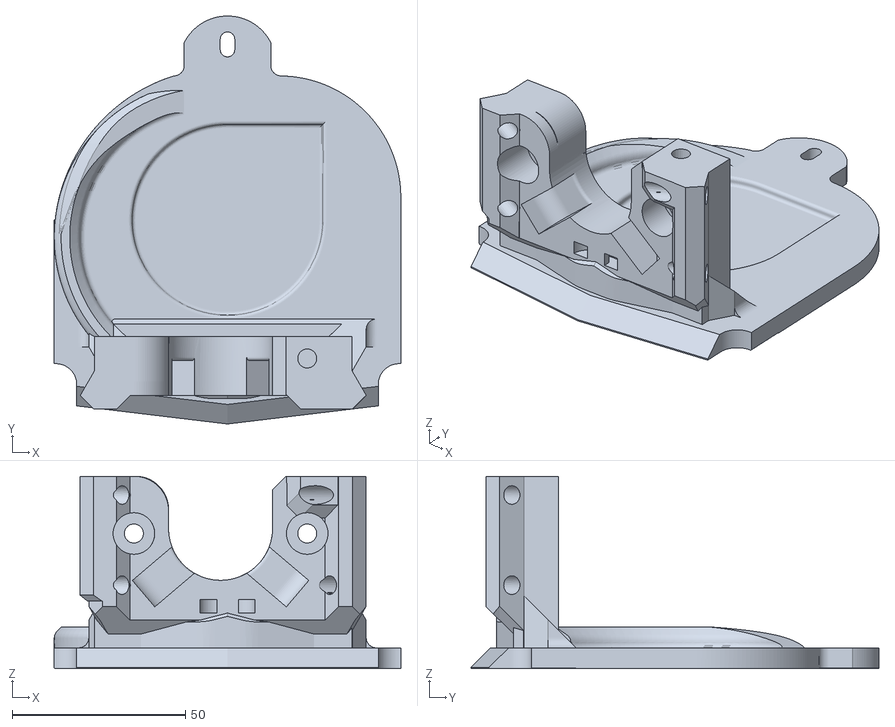
[picture p27: CAD file, 2016-07-21]
production_parts/printed_parts/extruder_mount/opah_extruder_mount_v1.2.stl
100.0 x 117.7 x 55.5
