alephobjects/taz-toolhead-opah/production_parts/printed_parts/fan_duct_left/fan_duct_left_v0.7.4.1d.stl

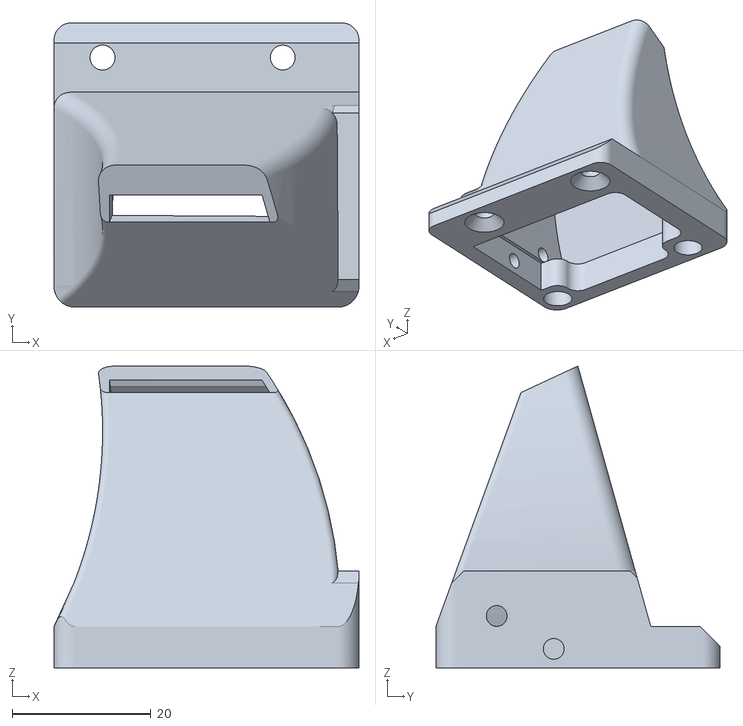
[picture p28: CAD file, 2016-06-20]
production_parts/printed_parts/fan_duct_left/fan_duct_left_v0.7.4.1d.stl
44.0 x 41.0 x 43.6
