alephobjects/taz-toolhead-opah/production_parts/printed_parts/heatsink_fan/heatsink_fan_duct_opah_v1.1.stl

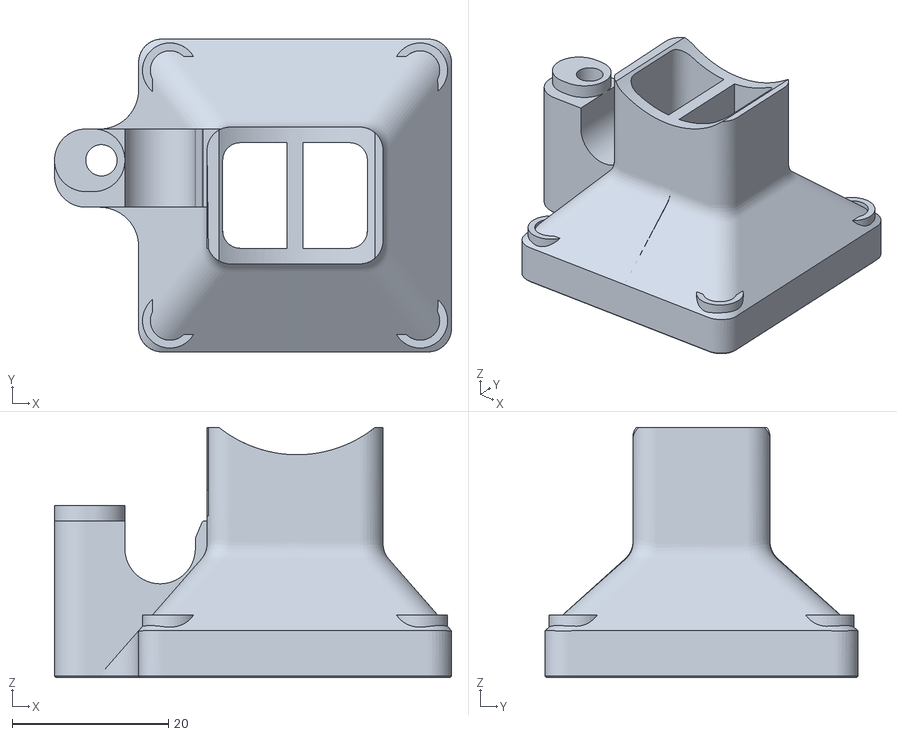
[picture p29: CAD file, 2016-06-28]
production_parts/printed_parts/heatsink_fan/heatsink_fan_duct_opah_v1.1.stl
50.8 x 40.0 x 32.0
