alephobjects/taz-toolhead-opah/production_parts/printed_parts/idler_latch/beefy_idler_latch_v2.2.fcstd

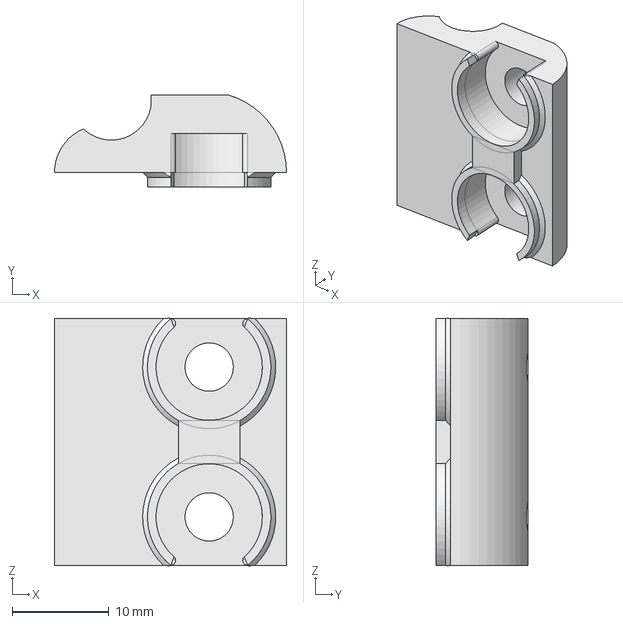
[picture p30: CAD file, 2016-06-15]
production_parts/printed_parts/idler_latch/beefy_idler_latch_v2.2.fcstd
24.0 x 9.50 x 25.6 mm
