alephobjects/taz-toolhead-opah/production_parts/printed_parts/large_herringbone_gear/herringbone_large_gear_v1.3.stl

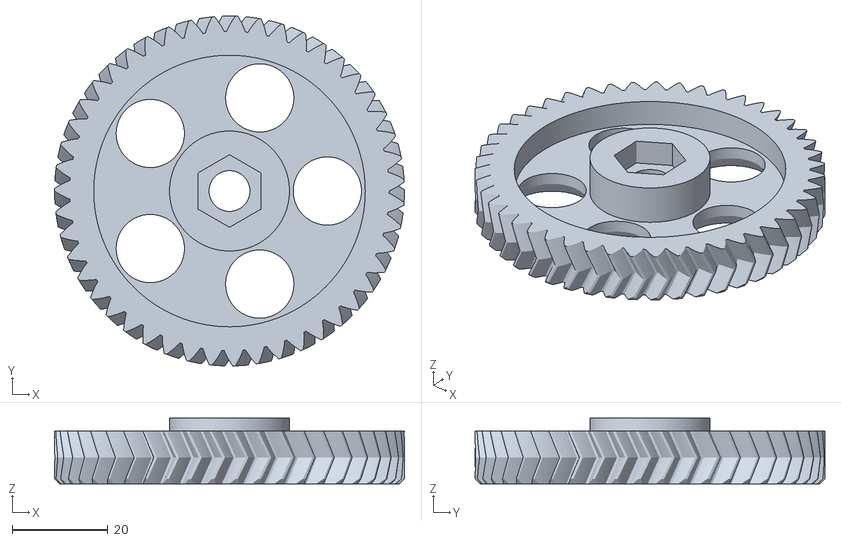
[picture p31: CAD file, 2016-06-20]
production_parts/printed_parts/large_herringbone_gear/herringbone_large_gear_v1.3.stl
73.0 x 73.0 x 13.8
