alephobjects/taz-toolhead-opah/production_parts/printed_parts/small_herringbone_gear/herringbone_small_gear-1.1-highres.stl

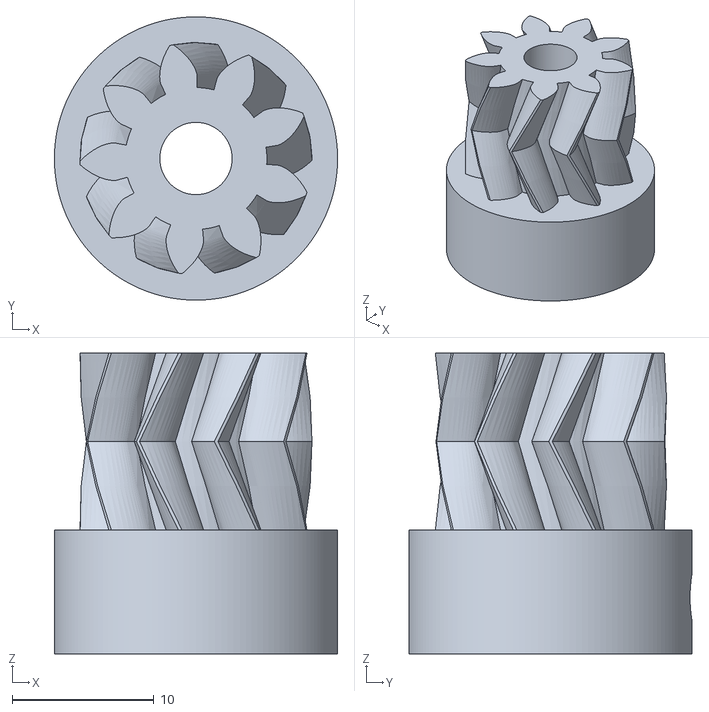
[picture p32: CAD file, 2016-06-20]
production_parts/printed_parts/small_herringbone_gear/herringbone_small_gear-1.1-highres.stl
20.0 x 20.0 x 21.2
