alephobjects/taz-toolhead-opah/production_parts/machined_parts/ATTIC/heatsink/Heat_Break_Tube.fcstd

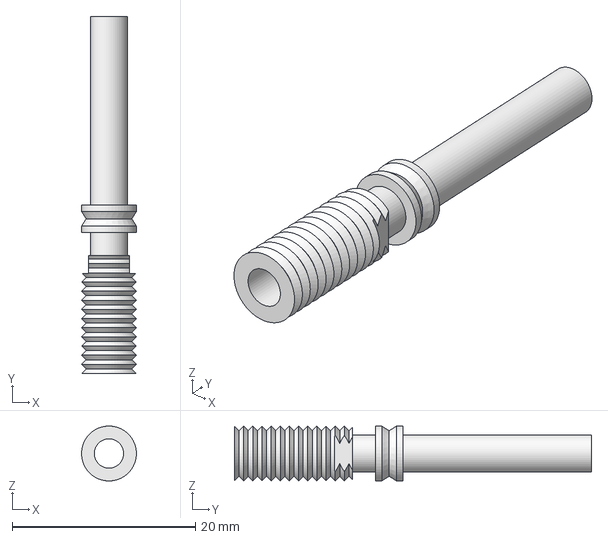
[picture p33: CAD file, 2016-05-05]
production_parts/machined_parts/ATTIC/heatsink/Heat_Break_Tube.fcstd
5.99 x 39.0 x 6.00 mm
