alephobjects/taz-toolhead-opah/production_parts/printed_parts/small_herringbone_gear/herringbone_small_gear-1.1-highres-x3.stl

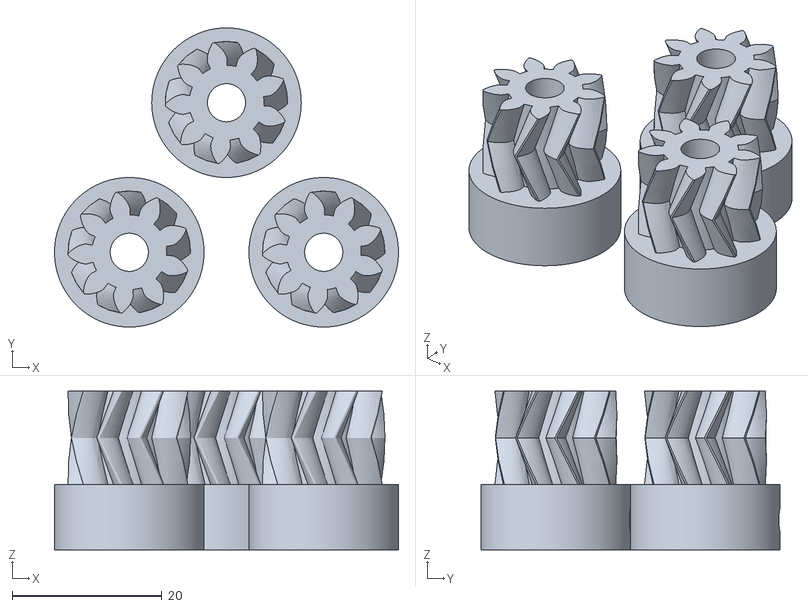
[picture p34: CAD file, 2016-06-20]
production_parts/printed_parts/small_herringbone_gear/herringbone_small_gear-1.1-highres-x3.stl
46.0 x 40.0 x 21.2
