alephobjects/taz-toolhead-opah/(list of files, cad)

Other CAD files:
production_parts/printed_parts/fan_duct_right/fan_duct_right_v0.7.4.1d.stl
images/4-13_opah.blend
images/opah_blend.blend
production_parts/jigs/flexy_heatsink_holder_v0.1.stl
production_parts/machined_parts/1.2mm-MOARstruder-nozzle/1.2mm-MOARstruder-nozzle_PP-MP0155_revB.fcstd
production_parts/machined_parts/ATTIC/heater_block/opah_heater_block_v0.9.stl
production_parts/machined_parts/MOARstruder-heatbreak/MOARstruder-heatbreak_PP-MP0152_revA.fcstd
production_parts/printed_parts/extruder_brace/opah_extruder_brace_v0.3.fcstd
production_parts/printed_parts/extruder_brace/opah_extruder_brace_v0.3.stl
production_parts/printed_parts/extruder_brace/opah_extruder_brace_v0.4.stl
production_parts/printed_parts/extruder_idler/beefy_extruder_idler_v0.4.stl
production_parts/printed_parts/extruder_washer/extruder_washer_v3.0-x16.stl
production_parts/printed_parts/extruder_washer/jonaskuehling_gregs-wade-ao-v3-washer-x7.stl
production_parts/printed_parts/extruder_washer/jonaskuehling_gregs-wade-ao-v3-washer.fcstd
production_parts/printed_parts/fan_duct_left/fan_duct_left_v0.7.4.1d.blend
production_parts/printed_parts/fan_duct_right/fan_duct_right_v0.7.4.1d.blend
production_parts/printed_parts/idler_latch/beefy_idler_latch_v2.2.stl
