alephobjects/taz-toolhead-opah/production_docs/notes/manufacturing_differences_between_tilapia_and_opah.odt

Differences between stock TAZ toolhead and opah maunfacture

- The opah adds a brace to the top of the extruder body.
  - There are now 2 M3 thermal inserts in the extruder bods
  - The brace gets secured to the extruder body using 2 M3x12 BHCS's
- The 2 24V fans that are spliced in parallel will now be spliced with solder sleeves instead of ferrules and heatshrink
  - The solder sleeve is digikey part number A104858-ND
- The thermistor assembly is now split into 2 pieces; a cartridge with short leads ending in a molex connector, and a jumper that leads form this to the 16 pin connector for the toolhead.
  - This jumper need to be 100mm wire length.
  - The prototype build has wires that will be
