alephobjects/taz-toolhead-opah/production_docs/pid_test_settings.ods

Sheet: Sheet1
PID autotune no fan 10 cycle |  |  |  | Super Caldera
 | Kp | ki | kd |  | Kp | ki | kd
1 | 34.77 | 1.03 | 294.79 | 1 | 45.06 | 8.73 | 58.14
2 | 69.48 | 8 | 150.83
3 | 110.68 | 19.79 | 154.71
4 | 35.34 | 3.63 | 85.93
5 | 70.67 | 13.91 | 89.73
6 | 95.34 | 17.9 | 126.92
7 | 54.81 | 6.76 | 111.13
8 | 114.41 | 20.24 | 161.67
Average | 73.1875 | 11.4075 | 146.96375 | Average | 45.06 | 8.73 | 58.14
PID autotune fan 10 cycle
 | Kp | ki | kd
1 | 30.97 | 5.91 | 40.59
2 | 39.81 | 7.84 | 50.55
3 | 46.45 | 8.86 | 60.88
4 | 36.67 | 6.58 | 51.07
5 | 30.97 | 5.73 | 41.85
6 | 30.97 | 5.32 | 45.03
7 | 27.87 | 5.49 | 35.39
8 | 30.97 | 5.91 | 40.59
Average | 34.335 | 6.455 | 45.74375

Sheet: Sheet2
1 | l2r
2 | 0.76
3 | 0.86
4 | 0.8
5 | 0.56
6 | 0.88
7 | 0.86
8 | 0.64
9 | 0.88
10 | 0.78
