alephobjects/taz-toolhead-opah/production_docs/prototype_production_part_name_changes.ods

Opah / Moarstruder naming convention update
Current PN | Current Name | New PN | New Name
EL-MS0184 | 24V 40W heater cartridge | EL-MS0184 | 24V 40W heater cartridge
EL-TH0012 | Cartridge style thermistor with molex connector | EL-TH0012 | Cartridge style thermistor with molex connector
PP-MP0151 / 0142 | Opah heatsink v1.0 | PP-MP0151_revA | MOARstruder-heatsink
PP-MP0152 | Opah heat break v1.0 | PP-MP0152_revA | MOARstruder-heatbreak
PP-MP0153 | Opah retention plate v1.0 | PP-MP0153_revA | MOARstruder-retention-plate
PP-MP0154 | Opah heater block v1.0 | PP-MP0154_revB | MOARstruder-heater-block
PP-MP0155 | 1.2mm Opah nozzle v1.0 | PP-MP0155_revB | 1.2mm-MOARstruder-nozzle
PP-MP0156 | Opah hotend mount plate v1.0 | PP-MP0156_revA | MOARstruder-mount-plate
