alephobjects/taz-toolhead-opah/production_parts/machined_parts/1.2mm-MOARstruder-nozzle/1.2mm-MOARstruder-nozzle_PP-MP0155_revB_p1.pdf

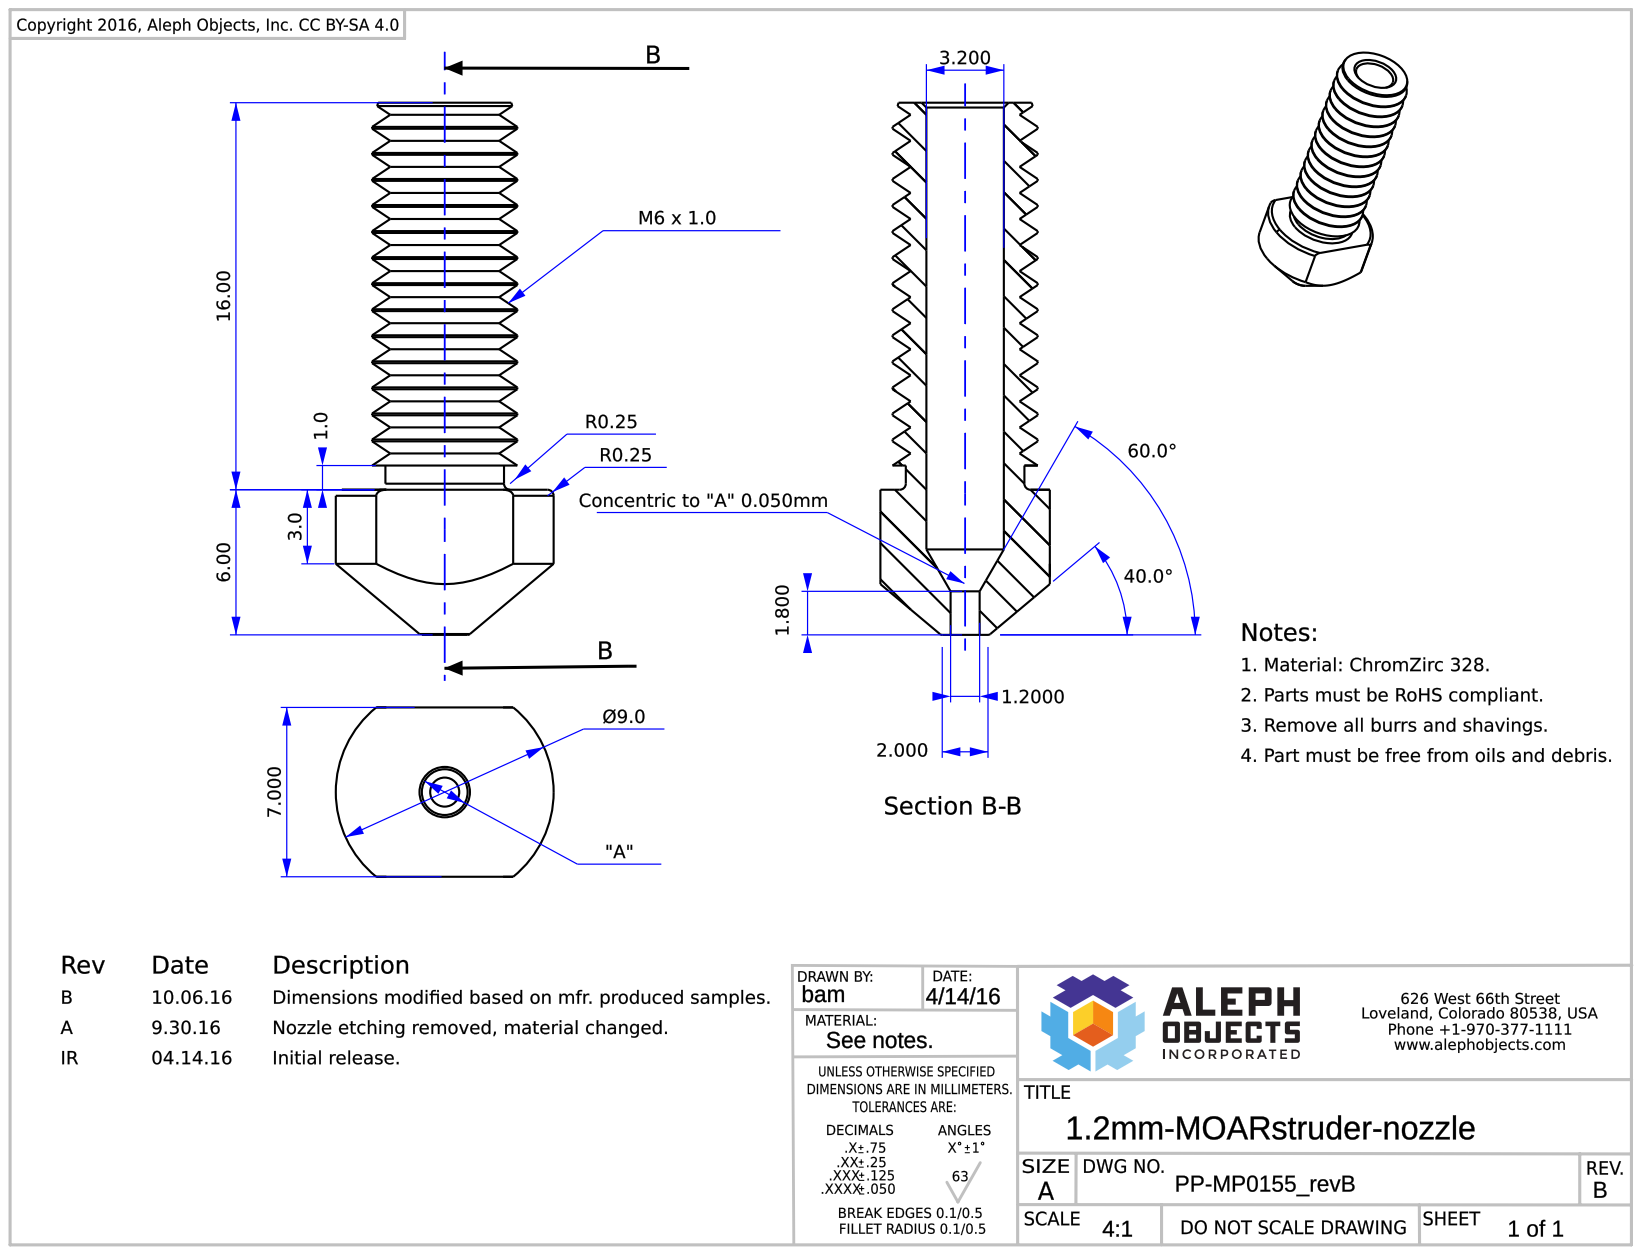
[picture p35: page 1]
