alephobjects/taz-toolhead-opah/production_parts/machined_parts/MOARstruder-heatbreak/MOARstruder-heatbreak_PP-MP0152_revA_p1.pdf

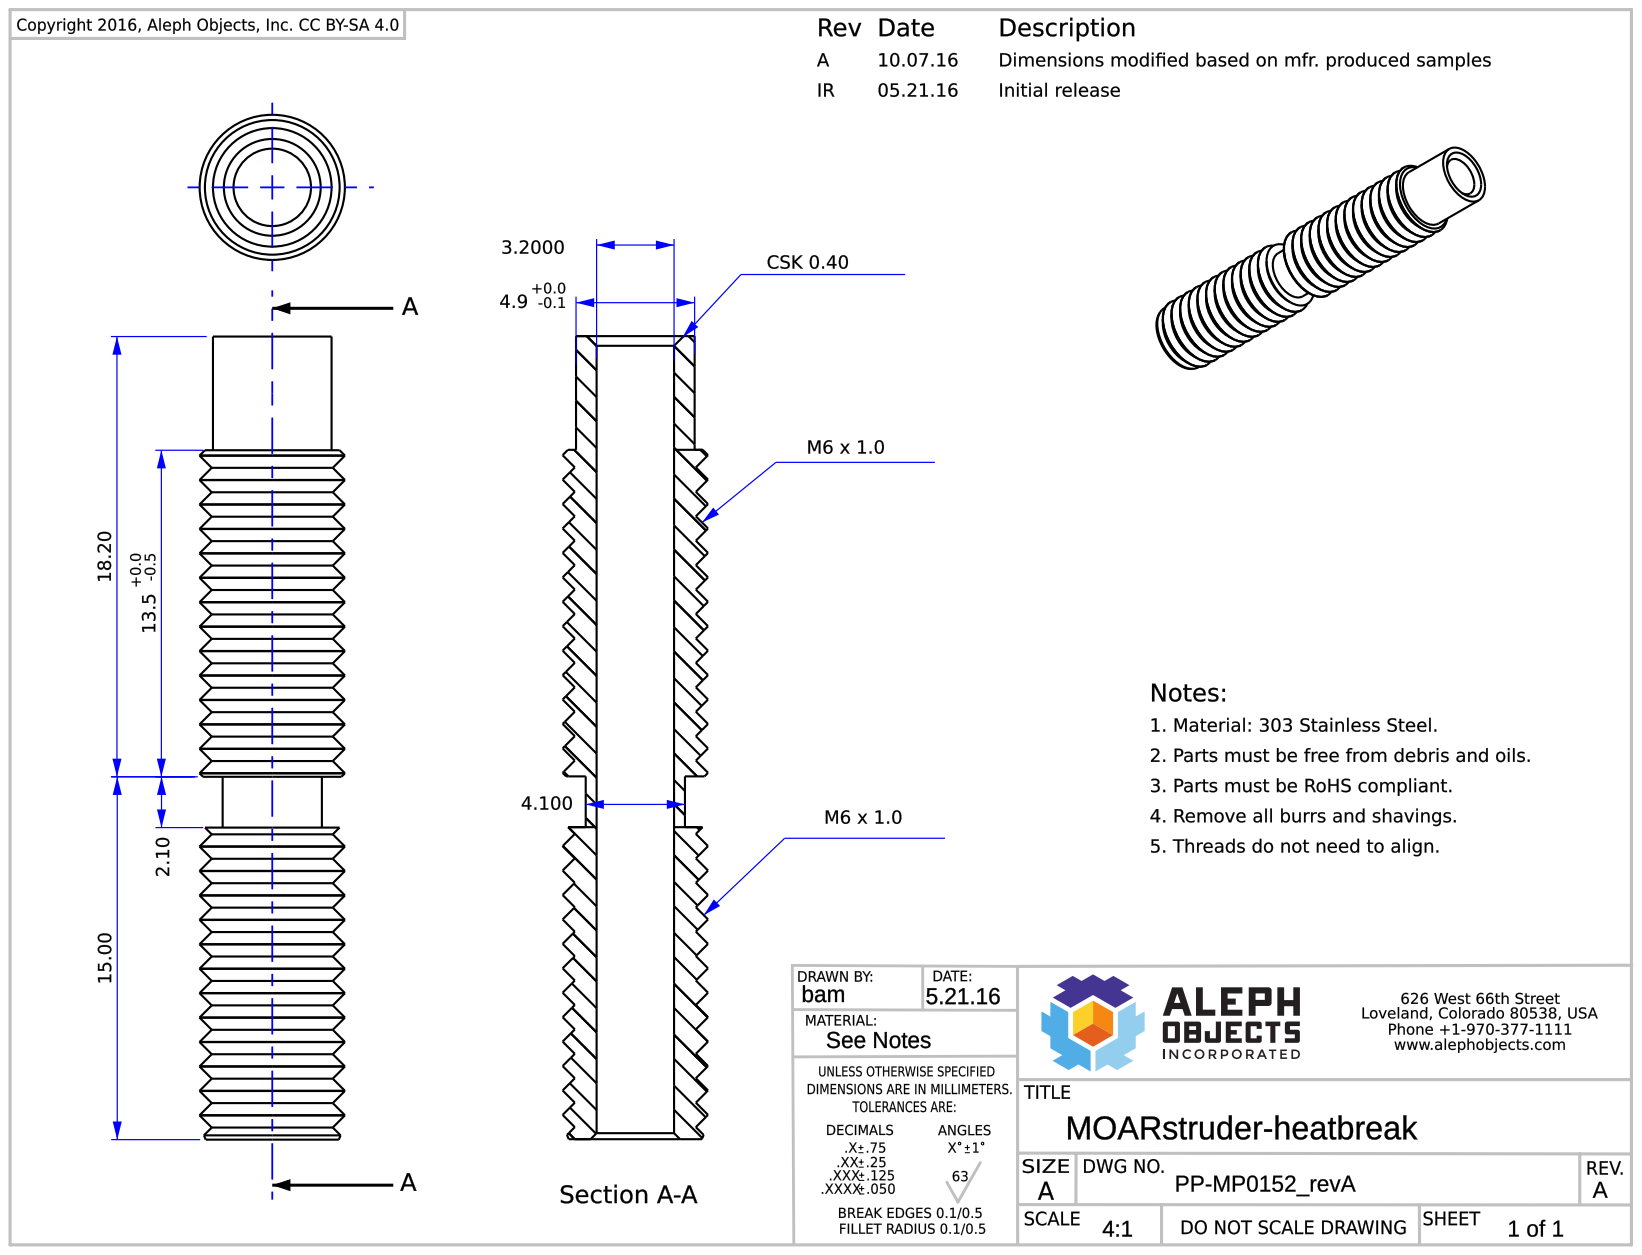
[picture p36: page 1]
