alephobjects/taz-toolhead-opah/production_parts/machined_parts/MOARstruder-heater-block/MOARstruder-heater-block_PP-MP0154_revB.pdf

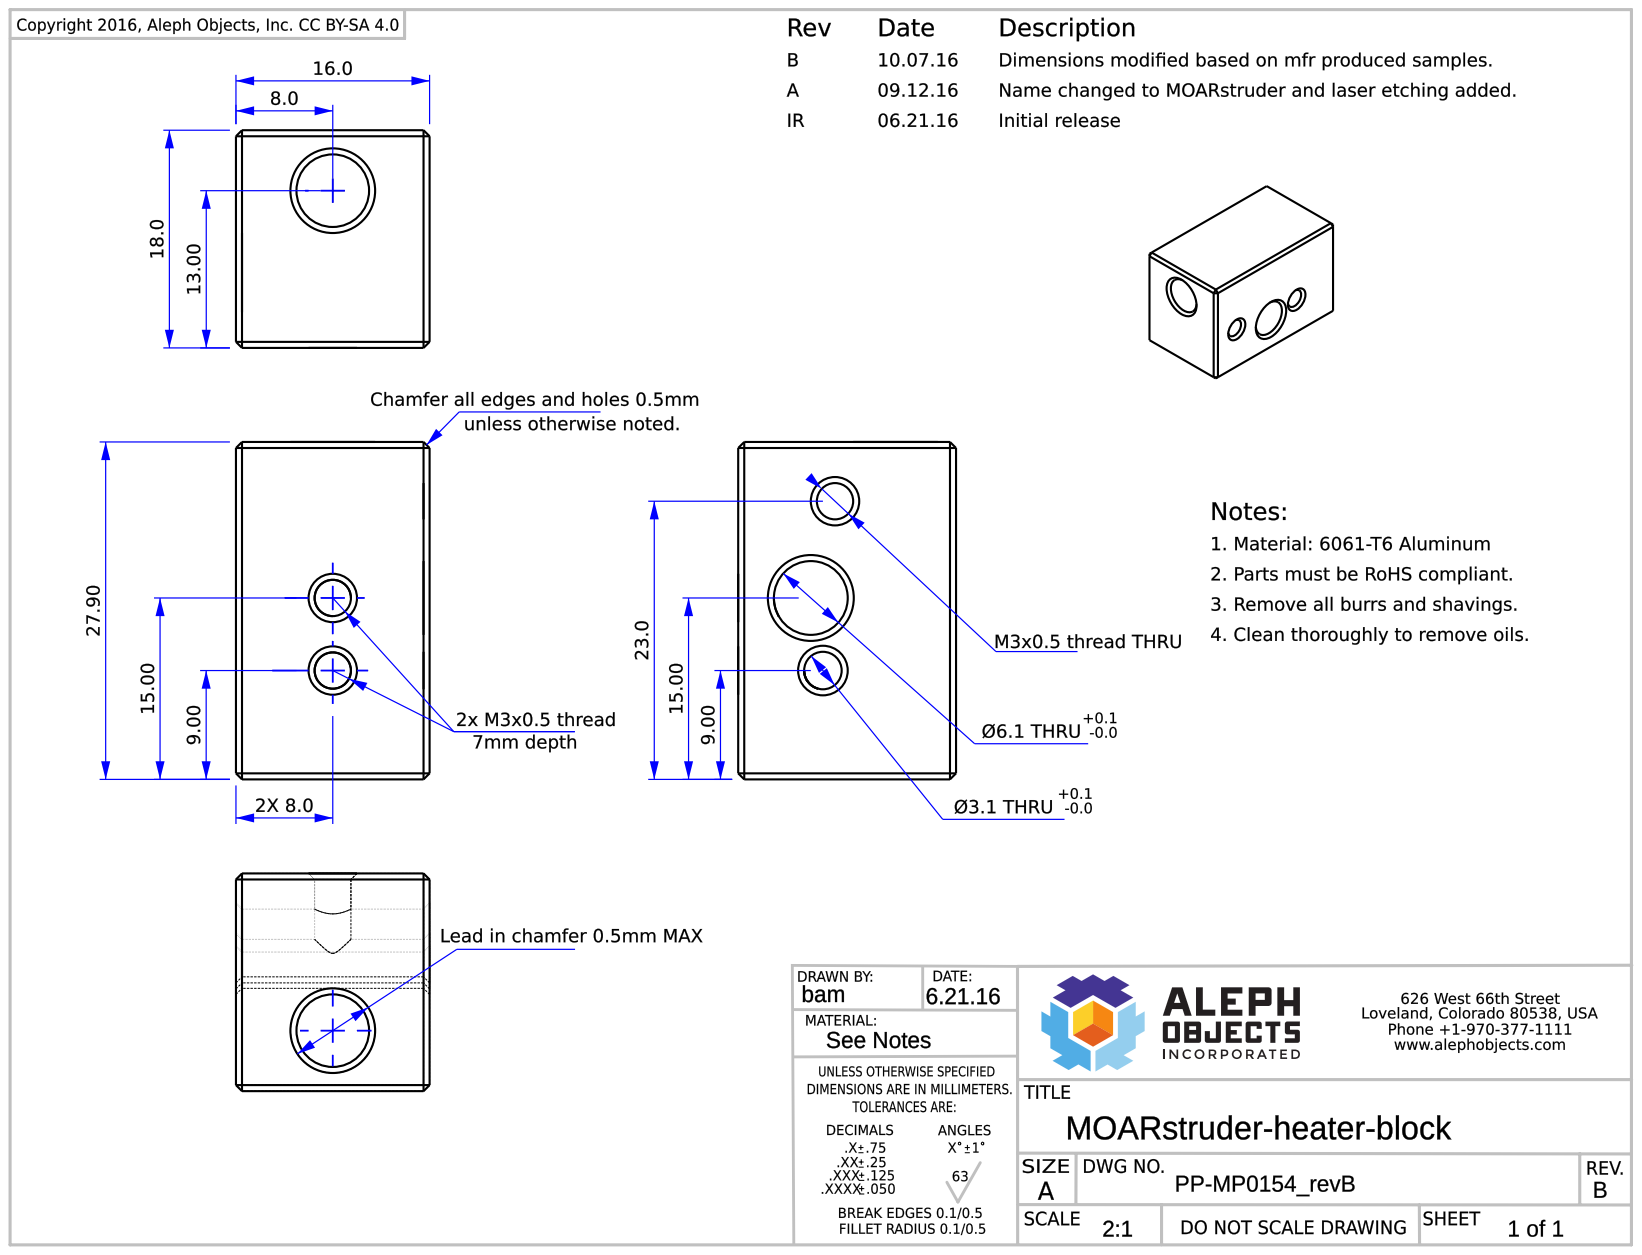
[picture p37: page 1]
