alephobjects/taz-toolhead-opah/production_parts/machined_parts/MOARstruder-heatsink/MOARstruder-heatsink_PP-MP0151_revA.pdf

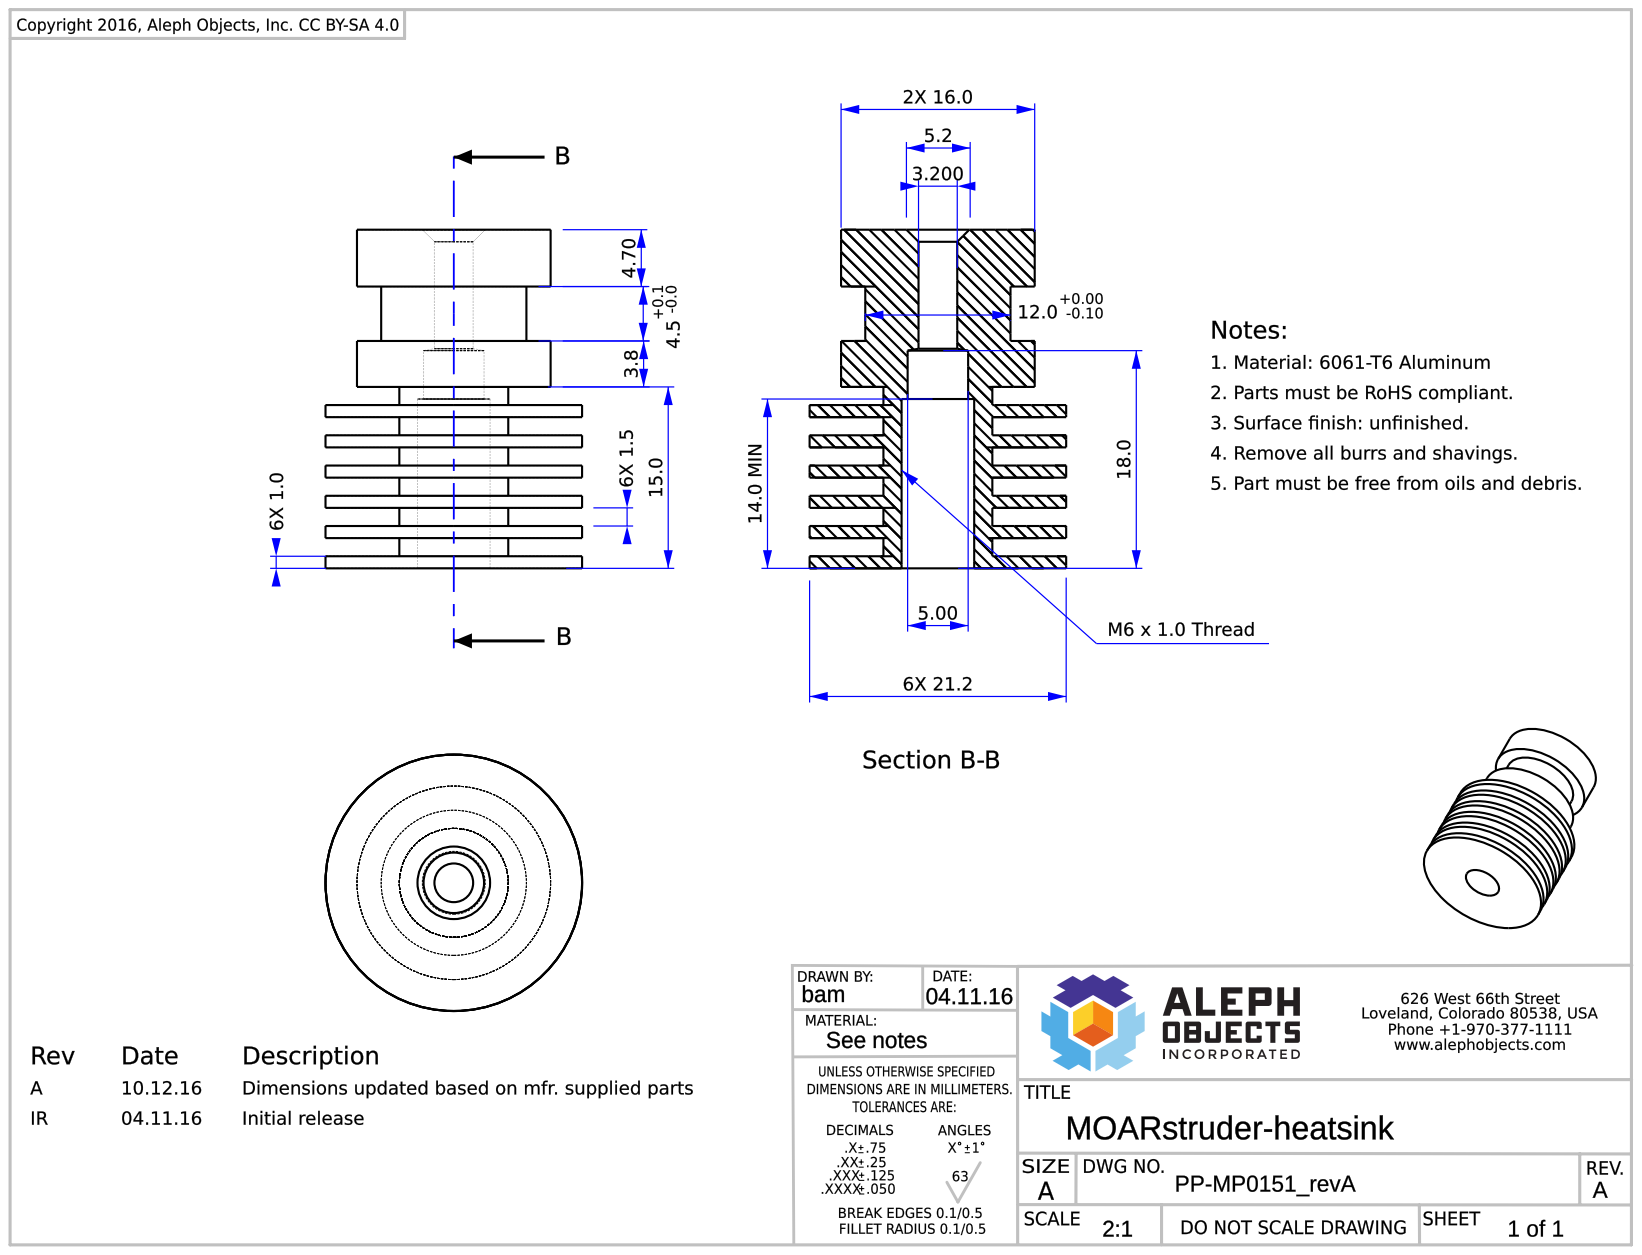
[picture p38: page 1]
