alephobjects/taz-toolhead-opah/production_parts/machined_parts/MOARstruder-mount-plate/MOARstruder-mount-plate_PP-MP0156_revA.pdf

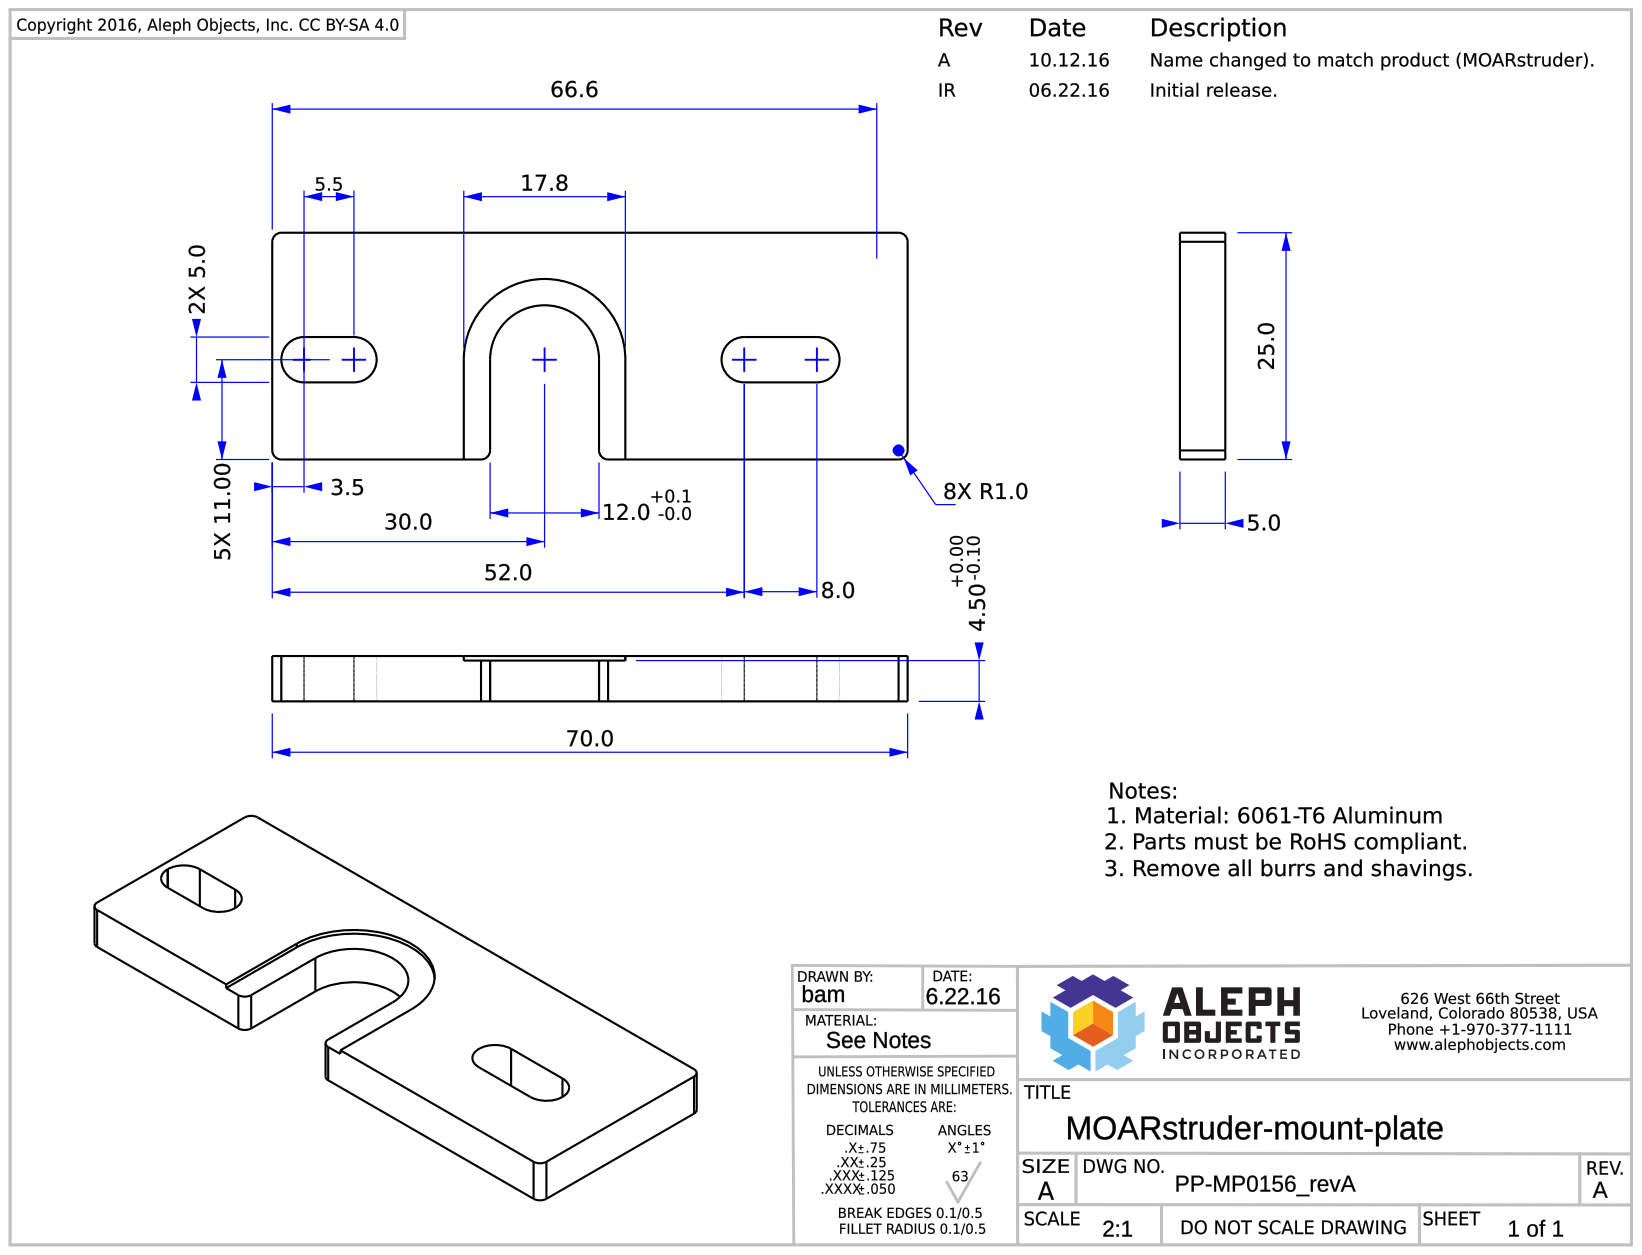
[picture p39: page 1]
