alephobjects/taz-toolhead-opah/production_parts/machined_parts/MOARstruder-retention-plate/MOARstruder-retention-plate_PP-MP0153_revA.pdf

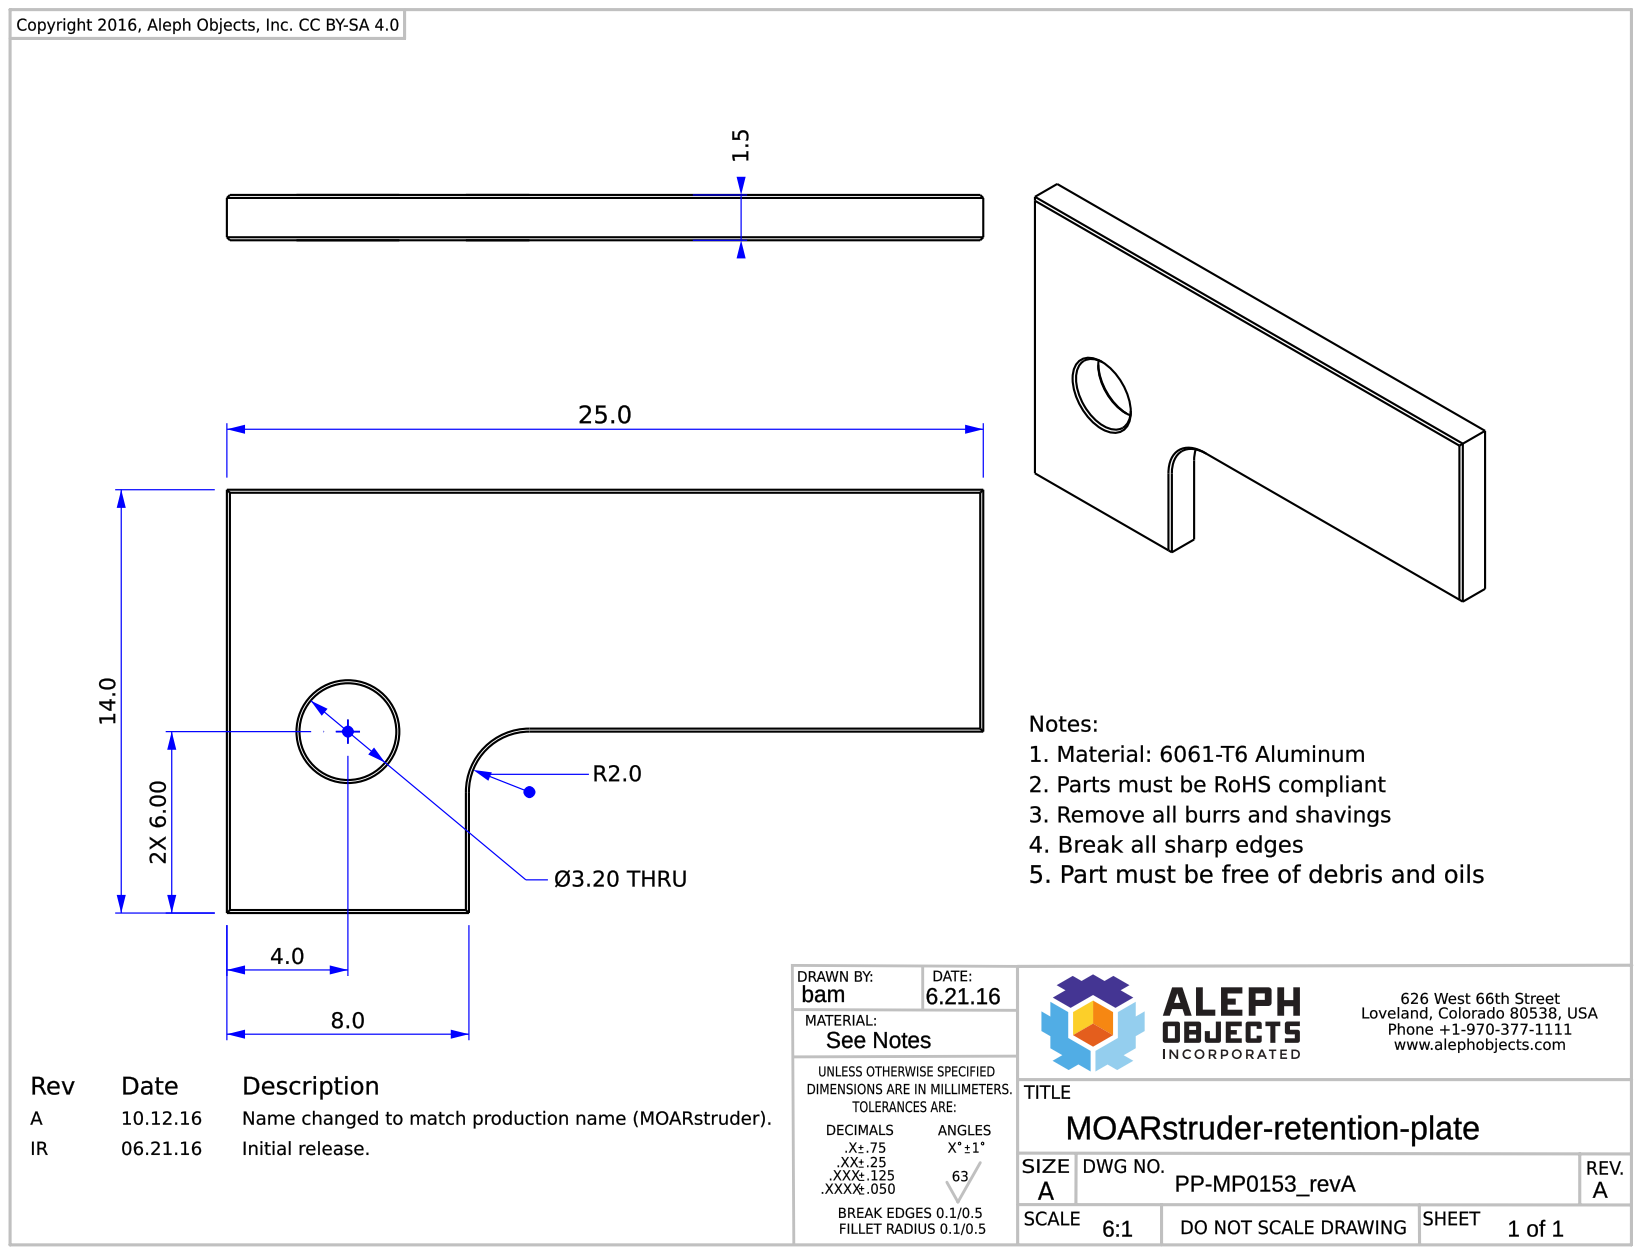
[picture p40: page 1]
