alephobjects/taz-toolhead-opah/production_parts/machined_parts/ATTIC/extended_retention_plate_v0.9_PP-MP0130.pdf

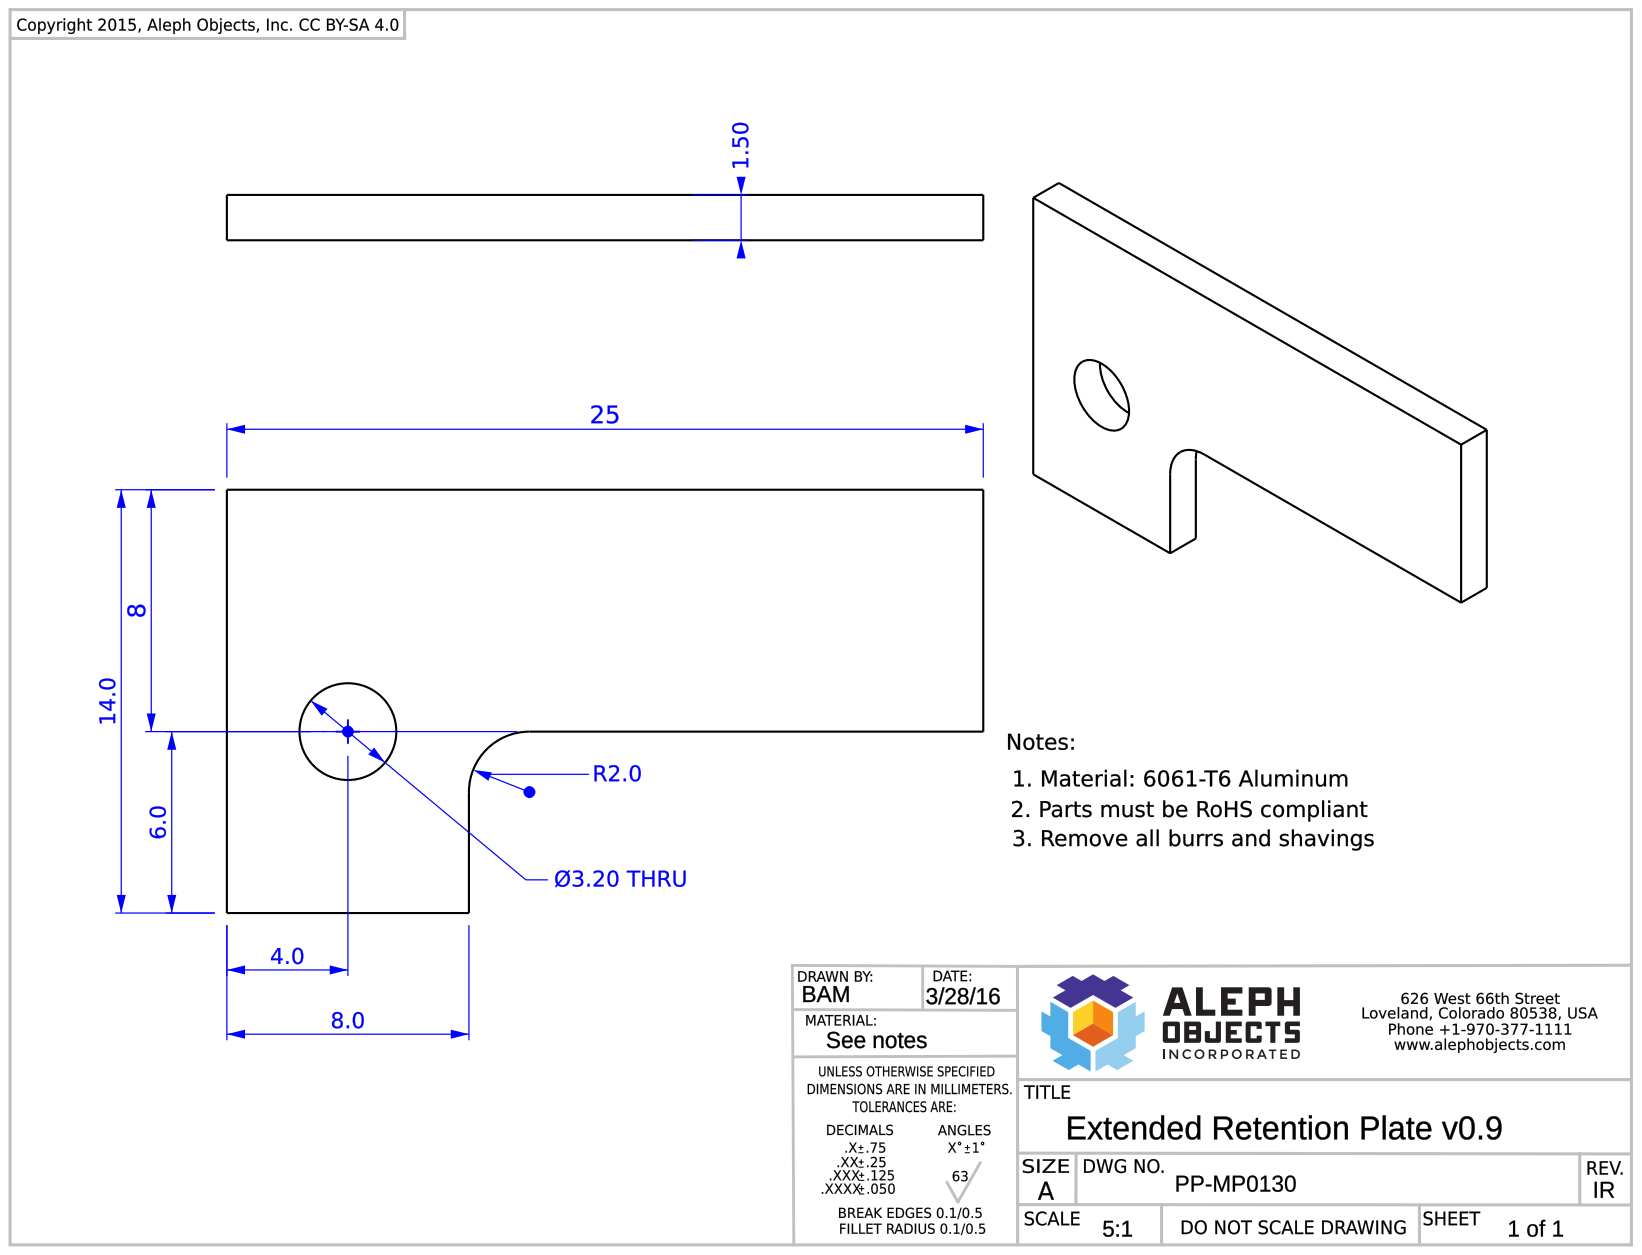
[picture p41: page 1]
