alephobjects/taz-toolhead-opah/production_parts/machined_parts/ATTIC/heater_block/opah_heater_block_v0.9-PP-MP0131.pdf

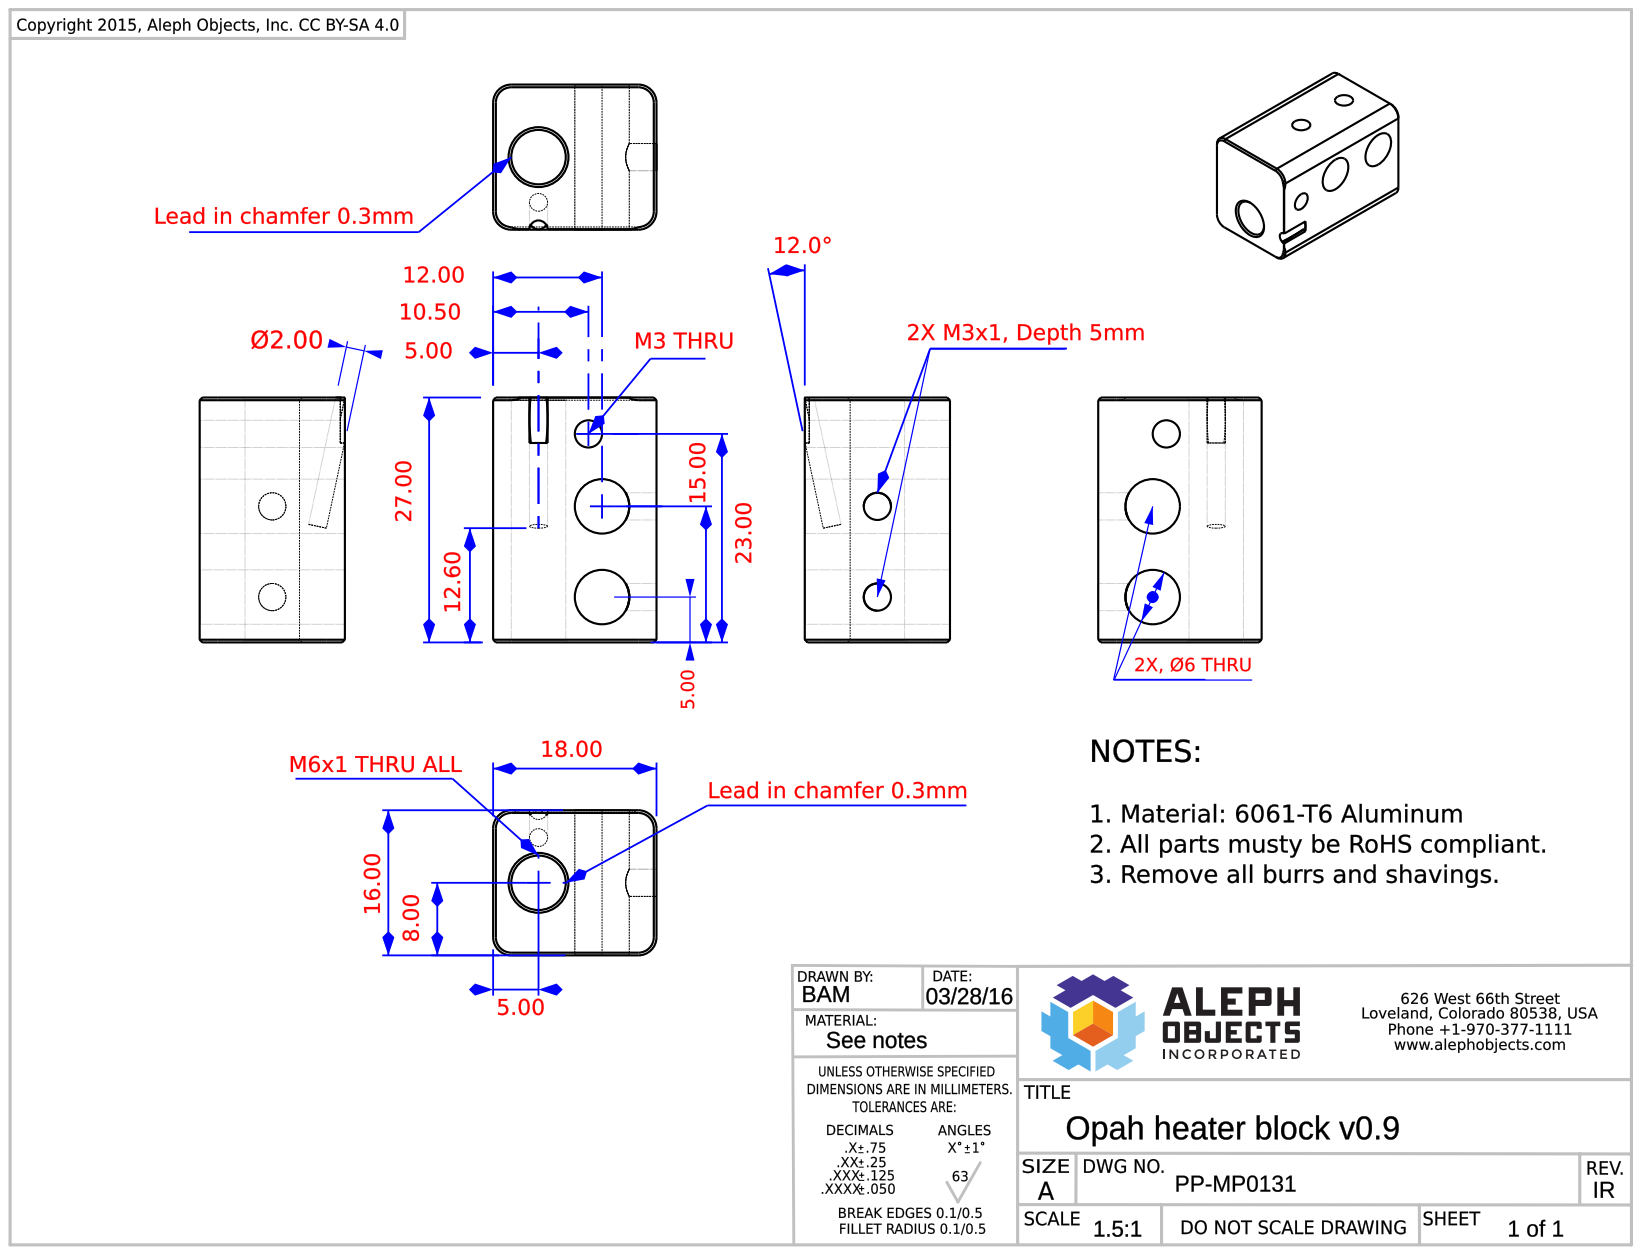
[picture p42: page 1]
