alephobjects/taz-toolhead-opah/(commit log)

2016-05-05 Initial commit to start the LulzBot TAZ tool head accessory, Opah.
    [3mmx1.2mm_nozzle_opah_v0.1.fcstd, 4-13_opah.blend, AO_style_long_heater_block_v1.0.fcstd, AO_style_long_heater_block_v1.0.stl, AO_style_long_heater_block_v1.1.fcstd, Cooling_Block_3mm_short.fcstd, HE-SH0046_high_output_hexagon_hotend_kit.ods, Heat_Break_Tube.fcstd]
2016-05-09 Removed print profiles directory. These profiles will now be tracked in the print-profiles directory
2016-05-10 highlighted changing parts in BOM
    [opah_BOM.ods]
2016-05-25 Add test firmware to directory.
    [Configuration.h, Configuration_adv.h]
2016-05-26 wireframe skull image added
2016-06-08 redesigned heatsink fan duct added for e3d style hotend
    [heatsink_fan_duct_opah_e3d.stl, idler_latch_v2.2.fcstd, idler_latch_v2.2.stl]
2016-06-08 opah extruder mount modified to fit the e3d hotend
    [opah_e3d_extruder_mount_v1.1.stl]
2016-06-15 .stl files added for all machined parts
    [heatbreak_opah_v0.1.stl, heatsink_fan_duct_opah_e3d_blended.stl, heatsink_opah_v0.3.stl, idler_latch_v2.2.fcstd, idler_latch_v2.2.stl, mounting_plate_opah.stl, opah_heater_block_v1.1.stl, opah_nozzle_1.2mm_v0.1.stl]
2016-06-20 added a modified heatsink fan mount for the opah
    [heatsink_fan_duct_opah_e3d_blended_v2.stl]
2016-06-20 BOM updated to reflect e3d supply
    [opah_BOM.ods]
2016-06-20 printed part directory modified and brought up to date
    [beefy_extruder_idler_v0.3.fcstd, beefy_extruder_idler_v0.3.stl, heatsink_fan_duct_opah_e3d.stl, heatsink_fan_duct_opah_e3d_blended.stl, heatsink_fan_duct_opah_e3d_blended_v2.stl, heatsink_fan_duct_opah_v1.1.stl, opah_e3d_extruder_mount_v1.1.stl, opah_extruder_body_v0.1.stl]
2016-06-20 heatsink fan mount modified for better fit
    [heatsink_fan_duct_opah_v1.1.stl]
2016-06-20 stl files for legacy parts added to repo for printing
    [extruder_washer_v3.0-x16.stl, fan_duct_left_v0.7.4.1d.blend, fan_duct_left_v0.7.4.1d.stl, fan_duct_right_v0.7.4.1d.blend, fan_duct_right_v0.7.4.1d.stl, herringbone_large_gear_v1.3.stl, herringbone_small_gear-1.1-highres-x3.stl, herringbone_small_gear-1.1-highres.stl]
2016-06-20 bom updated - toolhead fixing screw changed to SCHS instead of BHCS
    [opah_BOM.ods, opah_extruder_brace_v0.3.fcstd, opah_extruder_brace_v0.3.stl]
2016-06-20 BOM and part names cleaned up to match. part numbers are currently being generated
    [opah_BOM.ods, opah_idler_latch_v2.2.fcstd, opah_idler_latch_v2.2.stl]
2016-06-20 part numbers updated in the bom
    [opah_BOM.ods]
2016-06-23 part numbers updated for the machined components of opah
    [AO_style_long_heater_block_v1.1.fcstd, beefy_idler_latch_v2.2.fcstd, beefy_idler_latch_v2.2.stl, extended_retention_plate_v0.9.fcstd, extended_retention_plate_v1.0.fcstd, heatbreak_opah_v0.1.fcstd, heatbreak_opah_v1.0.fcstd, heatbreak_opah_v1.0.stl]
2016-06-24 mount plate added to the bom
    [opah_BOM.ods]
2016-06-28 heatsink fan duct insert hole size modified
    [heatsink_fan_duct_opah_v1.1.stl]
2016-06-28 printed part status document created
    [printed_part_status_opah.ods]
2016-06-29 updating printed part list
    [printed_part_status_opah.ods]
2016-07-01 production notes updated based on start of beta production run
    [flexy_heatsink_holder_v0.1.fcstd, flexy_heatsink_holder_v0.1.stl]
2016-07-05 opah extruder fan harness drawing added
2016-07-05 opah extruder pin assignment drawing added
2016-07-05 opah thermistor extension drawing added
2016-07-08 toolhead status tracker added
    [toolhead_status_7-8-16.ods]
2016-07-08 Add source code for TAZ 4-5 firmware, update TAZ 6 pid settings
    [Configuration.h, Configuration_adv.h]
2016-07-11 opah bom updated
    [opah_BOM.ods]
2016-07-11 adds info to status of B04 toolhead
    [toolhead_status_7-8-16.ods]
2016-07-21 printed part status document updated for preproduction run
    [printed_part_status_opah.ods]
2016-07-21 extruder body updated for mfg reccomendations
    [opah_extruder_body_v0.2.stl]
2016-07-21 opah extruder mount modified for symetry
    [opah_extruder_mount_v1.2.stl]
2016-07-21 final 2 parts released for production print profiling
    [printed_part_status_opah.ods]
2016-07-25 opah bom scrubbed 7.25 by bam
    [opah_BOM.ods]
2016-07-27 updating printed parts list
    [printed_part_status_opah.ods]
2016-07-29 added missing filament sample to the Opah BOM
    [opah_BOM.ods]
2016-08-01 clarified quantities and extended prices
    [opah_BOM.ods]
2016-08-05 Firmware mods for TAZ 4 5
    [Configuration.h]
2016-08-10 removed old PO info from BOM
    [opah_BOM.ods]
2016-08-11 Update firmware to be consistent with marlin phabricator
    [Configuration.h]
2016-08-17 release bom for purchasing
    [opah_BOM.ods]
2016-08-18 PO information for intial purchase
    [opah_BOM.ods]
2016-08-22 purchasing info
    [opah_BOM.ods]
2016-08-22 purchasing information
    [opah_BOM.ods]
2016-08-22 Update and reorganize the firmware
    [Configuration.h, Configuration_adv.h]
2016-09-09 added PO information to BoM
    [opah_BOM.ods]
2016-09-13 added PO information
    [opah_BOM.ods]
2016-09-13 updated printed parts status
    [printed_part_status_opah.ods]
2016-09-13 laser etching files added to heater block drawing
    [MOARstruder_heater_block_v1.0_PP-MP0154.fcstd, opah_heater_block_v1.0_PP-MP0154.fcstd]
2016-09-13 opah extruder brace modified to get rid of print defects
    [opah_extruder_brace_v0.4.fcstd, opah_extruder_brace_v0.4.stl]
2016-09-20 adding extruder brace
2016-09-20 added printed parts godes
2016-09-27 opah extruder brace modified for better printing
    [opah_extruder_brace_v0.4.fcstd]
2016-09-30 nozzle drawing modified to reflect changes verbally communicated to E3D
    [opah_nozzle_1.2mm_PP-MP0155revA.fcstd]
2016-10-11 Beefy extruder idler modified for better nut trap
    [beefy_extruder_idler_v0.3.fcstd, beefy_extruder_idler_v0.3.stl, beefy_extruder_idler_v0.4.fcstd, beefy_extruder_idler_v0.4.stl]
2016-10-11 Nozzle drawing updated based on recieved sample parts
    [1.2mm-MOAR-nozzle_PP-MP0155_revB.fcstd]
2016-10-11 Heatbreak drawing modified based on recieved sample parts
    [MOAR-heatbreak_PP-MP0152_revA.fcstd, heatbreak_opah_v1.0.fcstd, heatbreak_opah_v1.0.stl]
2016-10-11 MOARstruder heater block updated based on recieved sample parts
    [MOAR-heater-block_PP-MP0154_revA.fcstd, MOAR-heater-block_PP-MP0154_revIR.fcstd]
2016-10-11 Obsolete files removed
    [mounting_plate_PP-MP0117.fcstd, mounting_plate_opah.stl]
2016-10-12 release multi-level BOM, correct EL-WR0103, EL-WR0107 wire lengths
    [opah_BOMv2.1_MBOM.ods]
2016-10-12 Update with Purchasing BOM and Purchase details
    [opah_BOMv2.1_MBOM.ods]
2016-10-12 Add RM-MS0022 filament to BOM for Qty 2m
    [opah_BOMv2.1_MBOM.ods]
2016-10-12 Removed obsolete part files
    [1.2mm-MOAR-nozzle_PP-MP0155_revB.fcstd, 3mmx1.2mm_nozzle_opah_v0.1.fcstd, AO_style_long_heater_block_v1.0.fcstd, AO_style_long_heater_block_v1.0.stl, AO_style_long_heater_block_v1.1.fcstd, MOAR-heatbreak_PP-MP0152_revA.fcstd, MOAR-heater-block_PP-MP0154_revA.fcstd, MOAR-heater-block_PP-MP0154_revIR.fcstd]
2016-10-12 Added doc detailing all of the name and part number changes that go with the switch from prototype to production
    [prototype_production_part_name_changes.ods]
2016-10-12 MOARstruder nozzle part and drawings updated with new name and dimensions based on mfr supplied parts
    [1.2mm-MOARstruder-nozzle_PP-MP0155_revB.fcstd, 1.2mm-MOARstruder-nozzle_PP-MP0155_revB.step]
2016-10-12 Heatbreak updated with new naming convention and some dimensions modified to match manufacturer supplied parts.
    [MOARstruder-heatbreak_PP-MP0152_revA.fcstd, MOARstruder-heatbreak_PP-MP0152_revA.step]
2016-10-12 Heater block updated with production naming scheme
    [MOARstruder-heater-block_PP-MP0154_revB.fcstd]
2016-10-12 Heatsink updated to production naming scheme and new dimensions to match manufacturer supplied parts
    [MOARstruder-heatsink_PP-MP0151_revA.fcstd]
2016-10-12 Mount plate updated to the production naming scheme
    [MOARstruder-mount-plate_PP-MP0156_revA.fcstd]
2016-10-12 Moarstruder mount plate updated to the new naming scheme for production
    [MOARstruder-retention-plate_PP-MP0153_revA.fcstd]
2016-10-12 Add RM-MS0037 to BOM for qty 2m
    [opah_BOMv2.1_MBOM.ods]
